lDOCI/lDOCI.github.io/docs/Модификации.md

> [← Оглавление](index.md)

# Модификации

Печатные и аппаратные доработки AD5M/5M Pro. Модификации для **AD5X** — на [отдельной странице](AD5X-Печатные-модификации.md).

## Зашивка корпуса (термокамера)

Зашивка снижает разницу температур → меньше коробления ABS/ASA/композитов и отрывов PETG.

- [Родная зашивка FlashForge](https://wiki.flashforge.com/en/knowledge_corner/printer-mod-and-diy) — официальные модели/инструкция.
- [Минималистичная зашивка (мало печати)](https://www.printables.com/model/1002724-flashforge-adventurer-5m-enclosure/files).
- [Версия под акриловые панели от оригинальной зашивки](https://www.printables.com/model/1063430-flashforge-ad5m-minimal-enclosure).
- [Superliminal enclosure — панели + металлические уголки/профили](https://www.printables.com/model/1054835-superliminal-enclosure-for-flashforge-adventurer-5).
- [ILYAS mod](https://t.me/ILYAS_mod_AD5m) — канал с набором доработок.

## Вентиляция и термокамера

- [Вентиляционный канал под вентилятор 5015](https://www.printables.com/model/910736-ventiliatsionnyi-kanal-dlia-adventurer-5m5m-pro).
- [Угольный фильтр 7530](https://www.printables.com/model/1221854-flashforge-ad5m-filtr-ugolnyi-7530) — для 5M/5M Pro. Для 5X: [контейнер угольного фильтра](https://www.printables.com/model/1499836-ad5x-active-carbon-filter-container).
- [Задняя крышка под вентилятор 120 мм](https://www.printables.com/model/838021-flashforge-adventurer-5m-ad5m-back-panel-w-120mm-4) — охлаждение моторного отсека (помогает против перегрева драйверов).
- [Колпак-кожух на весь принтер](https://www.printables.com/en/model/863467-3d-printer-sound-dampening-enclosure) — шумоизоляция.

## Хотенд

Главная боль стока — картриджный хотенд: сопло меняется только в сборе и дорого. Решают заменой хотенда на вариант со сменными соплами. **Это разные хотенды, а не один и тот же:**

- **Bambu-mod** — печатная голова под хотенд **Bambu Lab** (X1C/P1S): дешёвые сменные сопла, хороший радиатор (нет пробок), удобное обслуживание. Печатать из ABS/ASA/композита. [Напечатать/собрать самому](https://www.printables.com/model/818473-flashforge-adventurer-5m-peredelka-pechatnoi-golov) · [версия с внешним вентилятором хотенда](https://www.printables.com/model/1002162-flashforge-adventurer-5m-bambu-lab-x1-hotend-mod).
- **Соплямод (соплемод)** — «франкенштейн»: радиатор и крепление от стока, хотенд от Bambu. Ставится **в родную голову**, ничего печатать не обязательно — но он немного длиннее стока, поэтому желательно распечатать новую крышку вентилятора обдува модели. Готовые версии на AliExpress: [v1](https://aliexpress.ru/item/1005008556375579.html) · [v2](https://aliexpress.ru/item/1005009895034159.html).
- **Conch** — **отдельный** готовый хотенд, без печати деталей: [AliExpress](https://aliexpress.ru/item/1005009996006548.html).
- **K1-мод** — печатная голова под хотенд **Creality K1**: [модель](https://www.printables.com/model/957502-ff-ad5m-k1-hotend).

**Разблокировка 291 → 320 °C** — см. [Прошивка](Прошивка.md#разблокировка-температуры-хотенда-291--320-c).

**Установка термистора PT1000** (рекомендуется при переходе на Bambu-mod — дешевле и стабильнее). Плата поддерживает нативно, в `printer.cfg`:
```
[extruder]
sensor_type: PT1000
pullup_resistor: 4700
```

> **Внимание:**
> Детали головы **нельзя печатать из PETG** (близко к горячей зоне — поплывут). Только ABS/ASA или нейлон.

## Обдув модели

Штатный обдув средний; кастомные сопла обдува (в т.ч. боковой под вентилятор 12032) печатают лучше стокового. Боковой обдув ставят на двусторонний скотч с подгонкой по высоте; полезен держатель PTFE-трубки для ровного загиба.

## Подсветка

Лента **24 В** подключается в жёлтый разъём платы с подписью **LED** (полярность подписана), коннектор **2pin XH2.54**.

- [Под обычную ленту 10 мм](https://www.printables.com/model/786611-flashforge-adventurer-5m-led-bar-with-magnets).
- COB-лента: [v1](https://www.printables.com/model/821534-adventurer-5m-led-light-mounts) · [v2](https://www.printables.com/model/831737-flashforge-adventurer-5m-ad5m-led-mod).
- [Две ленты на одно крепление](https://www.printables.com/model/828632-flashforge-adventurer-5m-ad5m-led-light-bars-mod-a).
- [Крепление понижающего LM2596](https://www.printables.com/model/827706-flashforge-adventurer-5m-ad5m-led-mod-accessory-bu) — для 12 В ленты (есть и способ без понижайки).
- Подсветка на голову — отдельные модели.

**Регулировка яркости из G-code.** Штатно подсветка только включается и выключается. Скрипт сообщества добавляет произвольную яркость — в `printer.base.cfg`:

```
[gcode_macro M355]
gcode:
  {% set S = params.S|default(1.0)|float %}
  SET_LED LED=chamber_led WHITE={S}
```

В секцию `[led chamber_led]` можно дописать стартовую яркость:

```
initial_white: 0.05
```

Теперь в стартовом и завершающем G-code доступно: `M355 S1.0` — включить на 100 %, `M355 S0.05` — притушить до 5 %.

## Нагреватель камеры

Активная камера нужна для композитов и крупного ABS. Ключевое по безопасности:

> **Внимание:**
> Нагреватель на 200 Вт — это ~10 А плюс вентилятор. **Питать его от штатного блока питания нельзя** — очень вероятно, что БП не выдержит. Либо ставьте БП на 450–500 Вт, либо питайте от отдельного источника.
>
> Управляющие блоки китайских наборов идут с реле сомнительного качества. Под такую нагрузку ставьте внешнее реле — например, 24 В / 30 А.

## Камера

- [Оригинальная камера FF](https://aliexpress.ru/item/1005006448963071.html) — штатное крепление, проще всего.
- Любая USB-веб-камера — в USB-порт экрана или обжать в задний разъём (список рабочих — в [Прошивке](Прошивка.md#камеры-usb)).
- [Держатель OV9726](https://www.printables.com/model/1252969-ov9726-camera-holder-ad5m) · [крепление OV3660](https://www.printables.com/model/1385004-ov3660-camera-mount-to-flashforge-adventurer-5m-ad) · [Arducam](https://www.printables.com/model/810240-flashforge-adventurer-5m-arducam-camera-mount) · [держатель под Logitech C310](https://www.printables.com/model/894405-logitech-c-310-camera-holder-for-flashforge-advent).

## Плата и питание

- **Кнопка вкл/выкл как на Pro** — вынос питания на лицевую панель (соблюдая ПБ по 220 В и предохранитель).
- **Обновление 5M → Pro** — программно добавляет часть функций (кнопка подсветки на экране); см. [Общее](Общее.md).
- **Снижение шума вентилятора БП** — замена/доработка обдува (см. также [Электроника](Электроника.md)).

## Внешний хост

Самая радикальная доработка после [замены процессора](Электроника.md#расширение-озу-замена-процессора-t113-s3--t113-m4). Смысл: Klipper и Moonraker переезжают на отдельный одноплатник (или старый ПК/ноутбук), а родная плата остаётся исполнителем. Потолок в 128 МБ перестаёт мешать.

**Что это даёт:**

- Уходит [E0017](Исправление-ошибок.md#e0017--move-queue-overflow) — очередь движений считает нормальный компьютер.
- Полноценный Klipper без урезаний, любые плагины.
- Телеграм-бот, таймлапсы, нормальная камера — всё то, что на родном хосте не влезает по памяти. Бота и так рекомендуют запускать вне принтера.
- Камеру можно повесить на тот же хост (`ustreamer` отдаёт поток на `IP_хоста:8080`, дальше URL прописывается в веб-морду).

**Чем платите:**

- Коробка с одноплатником рядом с принтером и провода наружу. Многие делают под это отдельную плату-переходник, чтобы сзади не было «релейного шкафа».
- Связь по USB чувствительна к наводкам — возможны дисконнекты. Ставьте нормальный экранированный кабель, не тяните длинный.
- Нужно корректно отключить родной Klipper, иначе два хоста дерутся за плату.
- Обслуживать теперь надо две системы.

**Инструкция:** [VoronKor / flashforge-adventurer-5m-connecting-an-external-host](https://github.com/VoronKor/flashforge-adventurer-5m-connecting-an-external-host-) — схема подключения и порядок настройки.

> **Совет:**
> Если цель — только убрать E0017 и получить веб-морду, начните с [мода на прошивку](Прошивка.md): это решается без паяльника. Внешний хост берут, когда упёрлись в память всерьёз — плагины, бот, вторая камера.

## Механика и ремни

Натяжители ремней, проставки против люфта, перепечатка креплений моторов, апгрейд на широкие ремни (Powge × D3vil K1) — в [Обслуживании](Обслуживание.md).
