lDOCI/lDOCI.github.io/docs/index.md

# База знаний — FlashForge Adventurer 5M / 5M Pro / 5X

Практическая вики по принтерам FlashForge Adventurer 5M / 5M Pro / 5X. Материал собран и обобщён из обсуждений сообщества в виде статей «как сделать / симптом → причина → решение».

## Разделы

| Страница | О чём |
|---|---|
| [Термины и сокращения](Термины.md) | Глоссарий: Klipper, root/SSH, карта стола, шейперы, PA, ретракт, IFS и т.д. — для новичков |
| [Частые проблемы (FAQ)](Решение-проблем.md) | Симптом → решение → ссылка: пробки, адгезия, поддержки, смещение слоёв, кирпич, ошибки |
| [Общее](Общее.md) | Недостатки AD5M и их устранение, отличия 5M / 5M Pro |
| [Прошивка](Прошивка.md) | Сток и моды, root/SSH, 291→320 °C, конфиги, датчики |
| [Калибровка](Калибровка.md) | Стол, тензодатчики, Z-offset, точность, натяжение ремней, шейперы, утилиты калибровки |
| [Обслуживание](Обслуживание.md) | Направляющие/смазка (Циатим-221F), ремни, шлейфы, хотенд, шестерни фидера |
| [Печать](Печать.md) | Засор/колдпул, первый слой, адгезия, поддержки, ретракты, дефекты |
| [Материалы](Материалы.md) | PLA/PETG/ABS/ASA/TPU/PA/PC, сушка, температуры |
| [Слайсер и профили](Слайсер-и-профили.md) | Orca-FF / OrcaSlicer, профили, стартовый/завершающий G-code, макросы |
| [Электроника и железо](Электроника.md) | Плата, моторы, драйверы, термисторы/PT1000, БП, датчики, восстановление |
| [Сеть и удалёнка](Сеть-и-удалёнка.md) | Wi-Fi, удалёнка, Home Assistant, боты, обновления/облака |
| [Модификации](Модификации.md) | Зашивки, обдув, термокамера, хотенд-моды, подсветка, камеры, плата |
| [Дефекты печати](Дефекты-печати.md) | 16 типовых дефектов (недоэкструзия, гостинг, паутина, варпинг…) — причины и решения с фото |
| [Филаменты (онлайн-таблица)](https://ldoci.github.io/filaments/) | Каталог катушек: тип, вес, размеры, ссылки на покупку — с фильтром и поиском |
| [Исправление ошибок](Исправление-ошибок.md) | Коды ошибок, E0017, E0011, восстановление серийника |

## AD5X

Отдельная линейка — Adventurer 5X с IFS, 220В-столом, 512 МБ ОЗУ и ножом обрезки филамента.

| Страница | О чём |
|---|---|
| [AD5X: Старт и различия](AD5X-Старт-и-различия.md) | Отличия от 5M, root/SSH, factory-прошивка, возврат на сток |
| [AD5X: Прошивка](AD5X-Прошивка.md) | Home offset, настройка ножа, регулировка корзины IFS |
| [AD5X: Реверс](AD5X-Реверс.md) | Система IFS (схемы, бэкап), размеры хотендов, сопла |
| [AD5X: Печатные модификации](AD5X-Печатные-модификации.md) | Bambu-каретка, кнопка питания, обдув, филамент-хаб |
| [AD5X: Корпус](AD5X-Корпус.md) | Зашивка, боковые панели, надстройки |

## Прошивки — актуальные версии

| Прошивка | Версия | Дата | Примечание |
|---|---|---|---|
| [ZMod](https://github.com/ghzserg/zmod) | 1.7.1 | 2026-05-14 | поверх стока, Fluidd, +AD5X |
| [Forge-X](https://github.com/DrA1ex/ff5m) | 1.4.1 | 2026-02-18 | развитие ZMod, максимум функций |
| [KlipperMod](https://github.com/xblax/flashforge_ad5m_klipper_mod) | v00.06-beta | 2025-09-08 | полная замена прошивки |
