lDOCI/lDOCI.github.io/docs/AD5X-Старт-и-различия.md

> [← Оглавление](index.md)

# AD5X: Основное

## Оглавление
1. [Отличия 5X от 5M](#отличия-ad5x-от-ad5m)
2. [Получение Root (SSH)](#1-получение-root-доступ-к-ssh)
3. [Видео по сборке/разборке](#2-официальные-видео-инструкции)
4. [Factory прошивка](#3-factory-прошивка-и-калибровка)
5. [Держатель катушки](#4-держатель-под-широкие-катушки)
6. [Возврат на сток](#5-установка-оригинальной-прошивки)
7. [Прижим ножа (Bambu Mod)](#6-прижимнаправляющая-ножа)

---

## Отличия AD5X от AD5M
Список технических изменений:

1. **Нагревательный стол:** 220В (вместо 24В).
2. **ОЗУ:** 512 Мб (вместо 128 Мб).
3. **IFS:** Система смены филамента установлена с завода.
4. **Плата головы:** Новая ревизия уменьшенного размера.
5. **Хотенд:** Изменена конструкция, установлен клон Bambu Lab (более доступные сопла).
6. **Кинематика:** Валы по оси X увеличены до 10 мм (ранее 8 мм).
7. **Питание:** Установлен новый блок питания.
8. **Тензодатчики:** Обновлена прошивка тензомодуля.
9. **Механика:** В голову добавлен нож для обрезки филамента.
10. **Датчики:** Установлен датчик застревания филамента.

---

## Объективные минусы AD5X и их решения

**Железо:**
- **Слабое сопло** → замена на сопло/хотенд Bambu Lab (A1 / A1 mini) или Triangle (размеры и ссылки — в [Реверс → сопла](AD5X-Реверс.md)).
- **Грелка хотенда часто горит** → замена головы на Bambu-mod либо отдельного нагревателя Bambu.
- **Щёлкают крепления катушки IFS** → меняют по гарантии.
- **Неудачный модуль 4-в-1 (IFS)** → замена по гарантии или печать своего.
- **Слетает прошивка модуля IFS** → высылают новый по гарантии, старый можно перешить.
- **Периодически теряется Z-offset** → снимать карту стола перед печатью; на ZMod — автоподбор Z-offset / плагин `g28_tenz`. На прошивке 1.1.9 есть попытка штатного решения, но она спорная — см. ниже.

**Софт:**
- **Закрытая прошивка** — работа только через родные Orca-FF / FlashPrint, китайские серверы периодически лежат.
- **Бьются файлы** при передаче — включить контроль MD5, см. [Исправление ошибок](Исправление-ошибок.md#битые-файлы-печати--проверка-md5).
- **Много отходов при смене цвета** — настраивается, см. ниже про IFS.
- **Нет веб-интерфейса, пережатая картинка камеры, нет поддержки сторонних камер.**
- **Кривой Z-offset на прошивке 1.1.9+** — у большинства становится хуже; решение — откат на 1.1.7.
- **Klipper вылетает при больших исключениях объектов** — отключить Exclude Objects в Orca.

> **Про софтовые пункты:**
> Почти все они закрываются установкой мода на прошивку — он даёт веб-интерфейс, доступ к конфигу, нормальную камеру и плагины. Что выбрать и как ставить — в статье [Прошивка](Прошивка.md).

---

## 1. Получение Root (Доступ к SSH)
SSH-сервис активен на принтере по умолчанию. Данный патч выполняет сброс пароля суперпользователя.

* **Скачать патч:** [Загрузить ZIP](https://github.com/lDOCI/Flashforge/releases/download/Adventurer/AD5X-root.tgz)

**Инструкция:**
1. Распаковать архив в корень USB-флешки.
2. Вставить флешку в выключенный принтер.
3. Включить принтер.
4. Дождаться полной загрузки и перезагрузить устройство.
5. **Логин:** `root`
6. **Пароль:** `root`

> Альтернативный способ: получение прав через [ZMOD](https://ghzserg.github.io/).

[Наверх](#оглавление)

---

## 2. Официальные видео-инструкции
Плейлист с процессом сборки и обслуживания узлов.

[Смотреть на YouTube](https://www.youtube.com/watch?v=sCWYyMsJgKA&list=PLJPwfr1YNWWlQWguuuYyE0y62yOKJvNY-)

---

## 3. Factory прошивка и калибровка
Сервисное ПО и программа для калибровки офсетов головы.

* **Скачать Factory Firmware:** [Ссылка на файл](https://github.com/lDOCI/Flashforge/releases/download/Adventurer/AD5X-factory-1.0.9.tgz)
* **Скачать Calibration Tool:** [Ссылка на файл](https://github.com/lDOCI/Flashforge/releases/download/Adventurer/xy.zip)

[Наверх](#оглавление)

---

## 4. Держатель под широкие катушки
Модифицированная модель держателя.

* **Скачать STL:** [Printables](https://www.printables.com/model/1219490-ad5x-spool-holder-remixed)

---

## 5. Установка оригинальной прошивки
Полная стоковая прошивка версии 1.0.9 (без ZMOD).

**Порядок действий:**
1. Загрузите следующие файлы в корень флешки:
 * `AD5X-factory-1.0.9.tgz`
 * `AD5X-factory.tar.xz`
 * `config.tar` (восстанавливать только при наличии ранее сделанного бекапа)
2. Вставьте флешку в принтер.
3. Перезагрузите устройство.

* **Источник файлов:** [GitHub ZMOD Releases](https://github.com/ghzserg/zmod/releases/tag/R)

[Наверх](#оглавление)

---

## 6. Прижим/направляющая ножа
Модификация для голов с установленным хотендом от Bambu Lab. Устраняет зажевывание пластика при печати TPU.

* **Скачать STP:** [Ссылка на файл](https://github.com/lDOCI/Flashforge/releases/download/Adventurer/ad5x_.stp)

**Требования к установке:**
1. Перед монтажом сдвинуть хотенд максимально низко.
2. После установки **обязательно** выполнить перекалибровку стола.

[Наверх](#оглавление)
