lDOCI/lDOCI.github.io/docs/Дефекты-печати.md

> [← Оглавление](index.md)

# Дефекты печати — причины и решения

Справочник по типовым дефектам качества печати (на основе официальной методички FlashForge и опыта сообщества). У каждого дефекта — фото проблемы, причина и решение; скриншоты настроек убраны в сворачиваемые блоки, чтобы не мешали читать.

Связанные статьи: [Печать](Печать.md) · [Калибровка](Калибровка.md) · [Материалы](Материалы.md).

---

## 1. Недоэкструзия (пластика выдавливается мало)
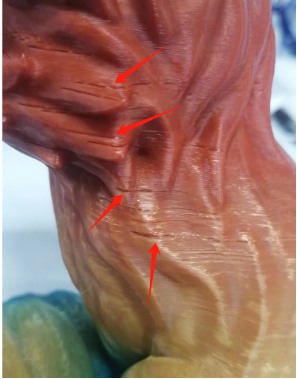
[picture p9: docs/assets/problems/1.under_extrusion_during_printing.png]


**Причина 1 — плохой/неподходящий филамент или низкая температура.**
- Замените филамент; выставьте температуру по рекомендации с катушки (+~15 °C из-за нержавеющего сопла, см. [Печать](Печать.md)).

**Причина 2 — нагар/закоксовка в сопле.** Признак: при ручной подаче нить тоньше 0.45 мм (норма 0.5 ± 0.03 мм).
- Замените сопло или сделайте cold pull ([Печать](Печать.md)).

## 2. Линии слоёв (видны полосы по высоте)
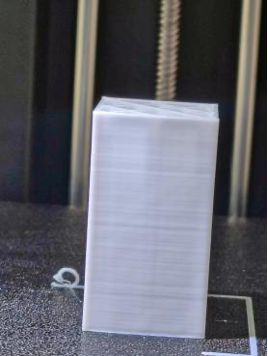
[picture p10: docs/assets/problems/2-1.layer_lines_on_3d_prints.png]


**Причина — неплавное движение по оси Z** (шум/подклинивание).
- Смажьте ходовой винт Z (подробно — в [Обслуживании](Обслуживание.md)).
- Если смазка не помогла, причина глубже: биение ходового винта, люфт антивоблинговых гаек, неравномерный ход трёх кареток Z. Подробный разбор с замерами — [PDF «Полосы по оси Z»](assets/pdf/Полосы-по-оси-Z-разбор.pdf).

<details markdown="1"><summary>Шаги смазки винта Z (скриншоты)</summary>

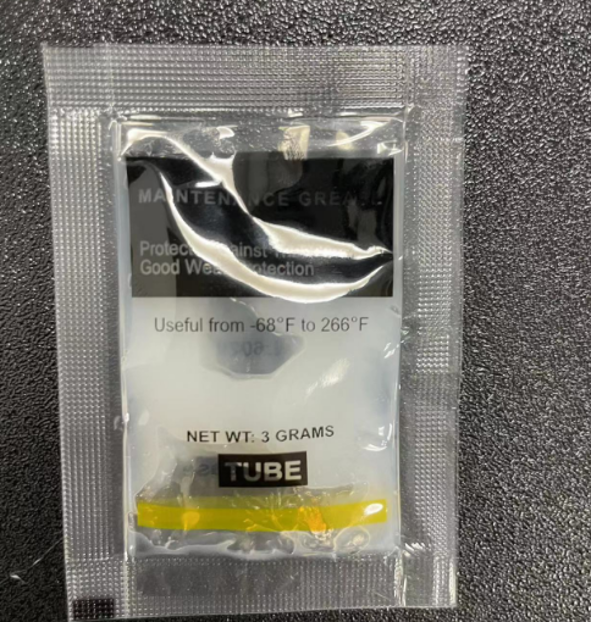
[picture p11: docs/assets/problems/2-2.layer_lines_on_3d_prints.png]

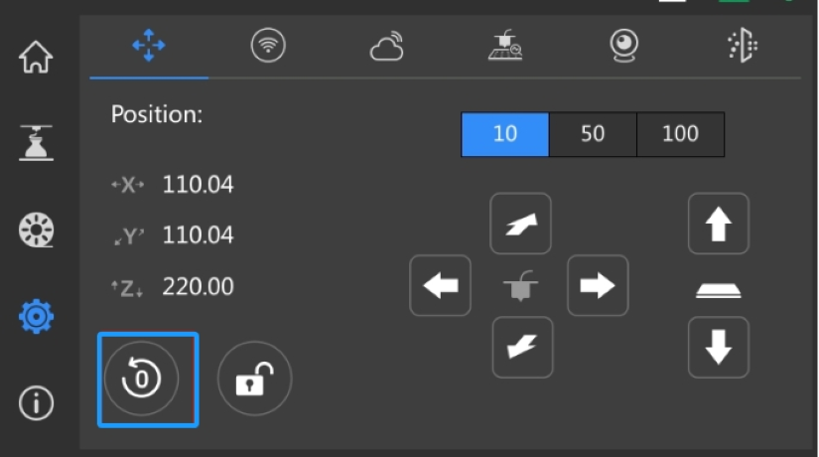
[picture p12: docs/assets/problems/回零.png]


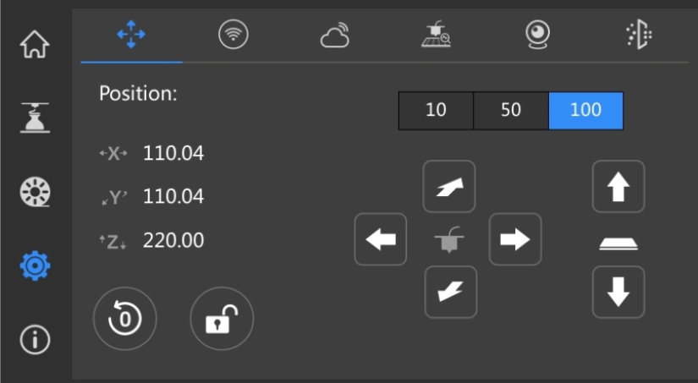
[picture p13: docs/assets/problems/100site2.png]


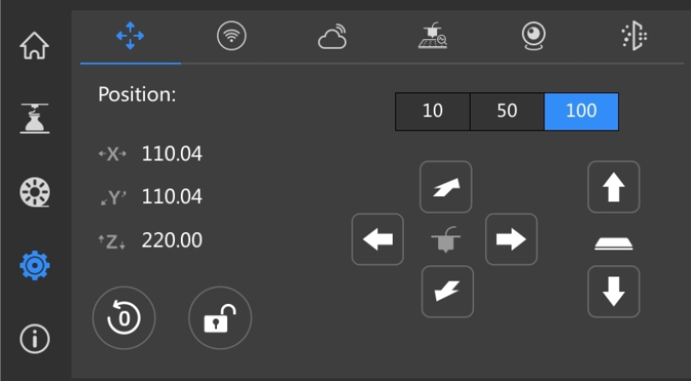
[picture p14: docs/assets/problems/100site.png]


</details>

## 3. Гостинг (эхо) и звон (ringing)
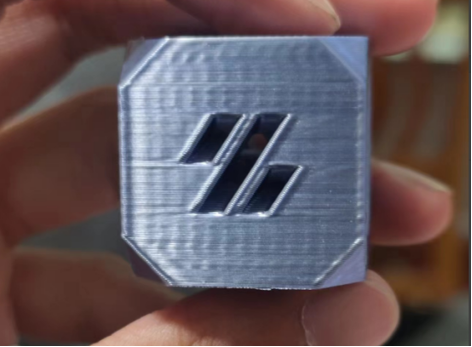
[picture p15: docs/assets/problems/3-1.ghosting&ringing.png]


**Причина — слабое натяжение ремней / высокое ускорение.**
- Подтяните ремни и пересоберите Input Shaper ([Калибровка](Калибровка.md)).
- Снизьте ускорение в Orca: *Speed → Acceleration → Normal printing*.

<details markdown="1"><summary>Настройка ускорения</summary>

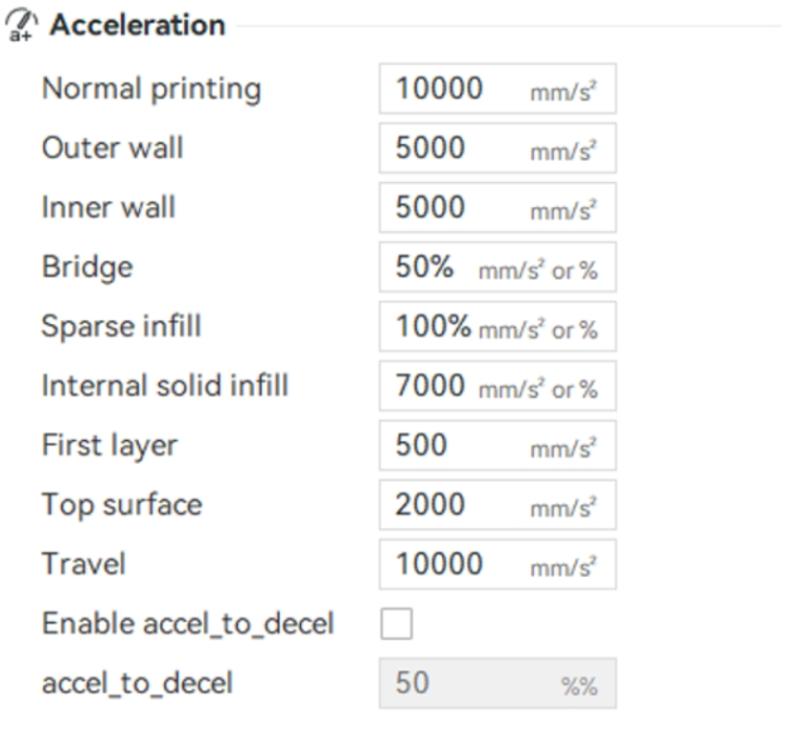
[picture p16: docs/assets/problems/加速度.png]

</details>

## 4. Провисание нависаний (droopy overhangs)
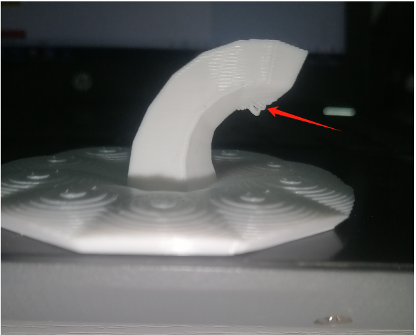
[picture p17: docs/assets/problems/4-1.droopy_overhangs.png]


- Включите *Slow down for overhangs* в Orca.
- Добавьте поддержки для нависаний круче 30°.
- Усильте обдув / увеличьте время остывания слоя.
- Проверьте вентилятор обдува детали (мог выйти из строя).

<details markdown="1"><summary>Настройки (нависания, охлаждение)</summary>

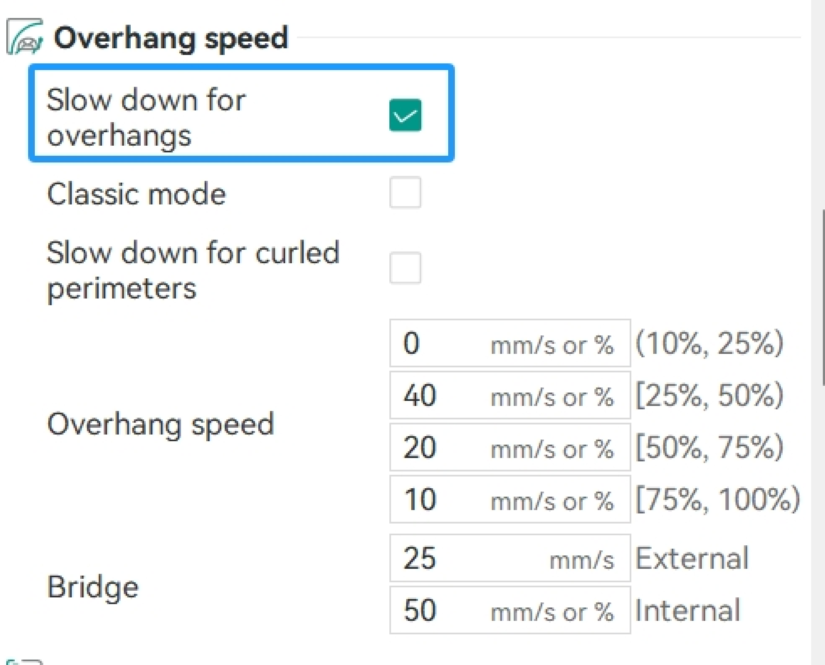
[picture p18: docs/assets/problems/悬垂降速.png]

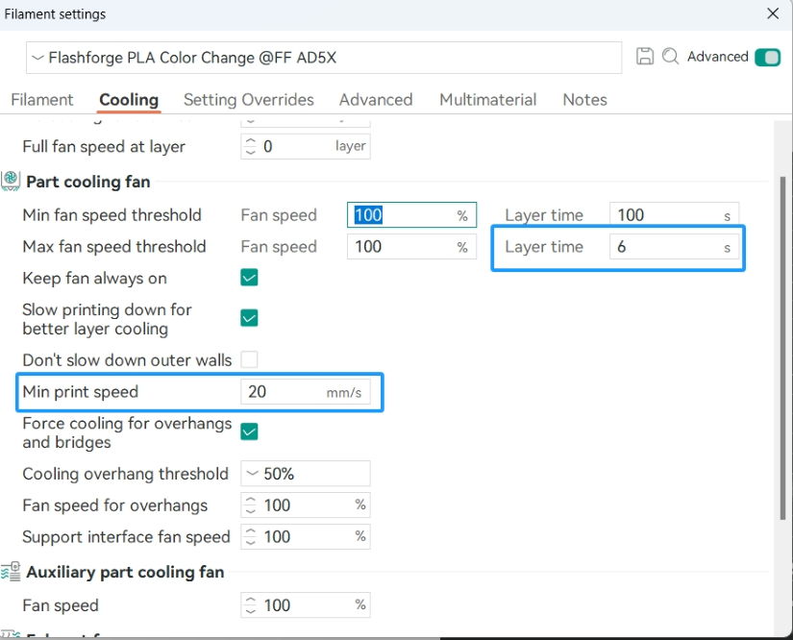
[picture p19: docs/assets/problems/冷却.png]

</details>

## 5. Паутина / стрингинг (тонкие нити между деталями)
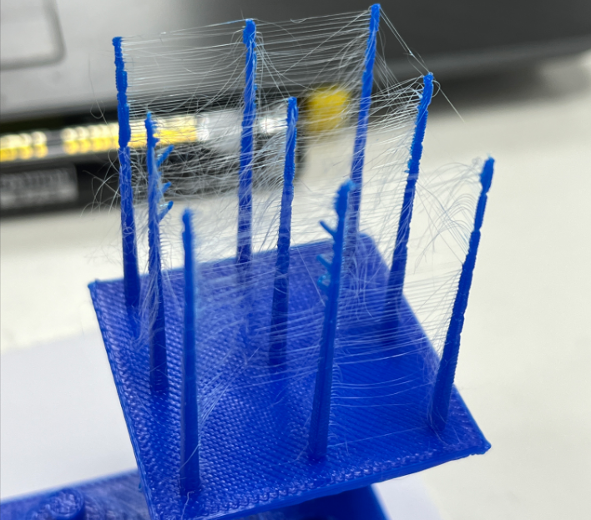
[picture p20: docs/assets/problems/5-1.stringing.png]


- **Просушите филамент** (PLA, PETG, PLA-CF особенно гигроскопичны) — см. [Материалы](Материалы.md).
- Увеличьте дистанцию и скорость отката (retraction) в Orca.

<details markdown="1"><summary>Настройки отката</summary>

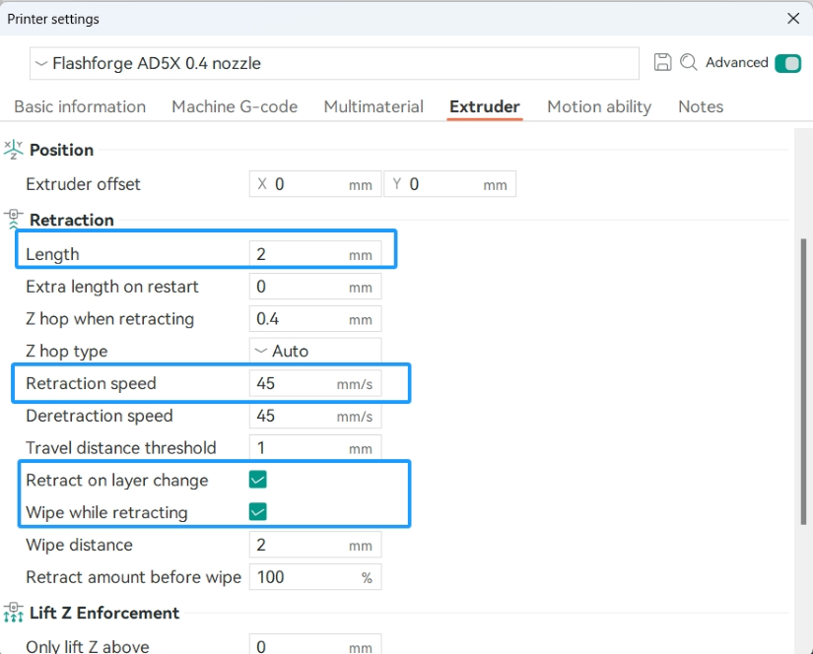
[picture p21: docs/assets/problems/回抽设置.png]

</details>

## 6. Шероховатость на мелких зонах (FlashPrint 5)
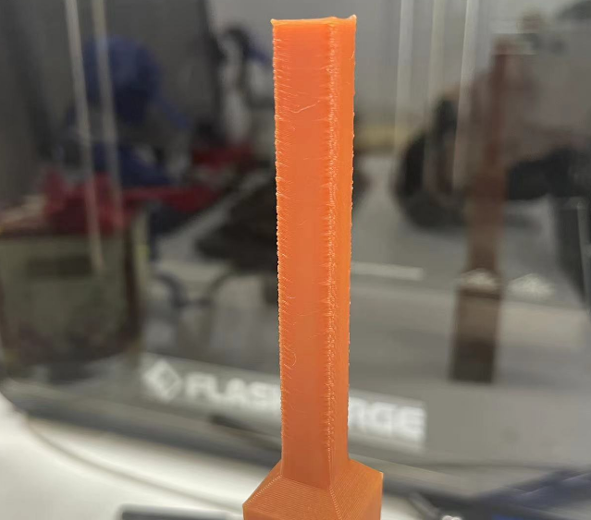
[picture p22: docs/assets/problems/6-1._for_models_sliced_by_flashprint_5.png]


- Настройте порог *Max fan speed threshold*, чтобы принтер замедлялся на коротких слоях.

<details markdown="1"><summary>Настройка</summary>

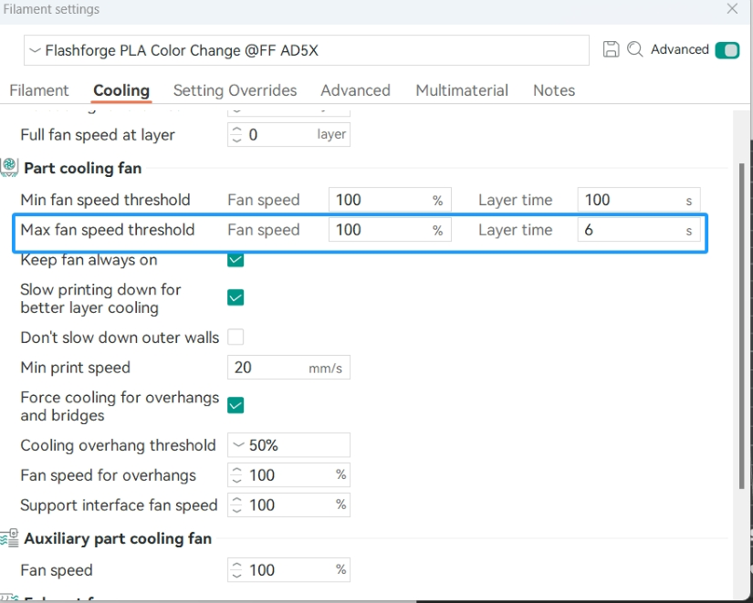
[picture p23: docs/assets/problems/冷却降速.png]

</details>

## 7. Зазоры между заполнением и контуром
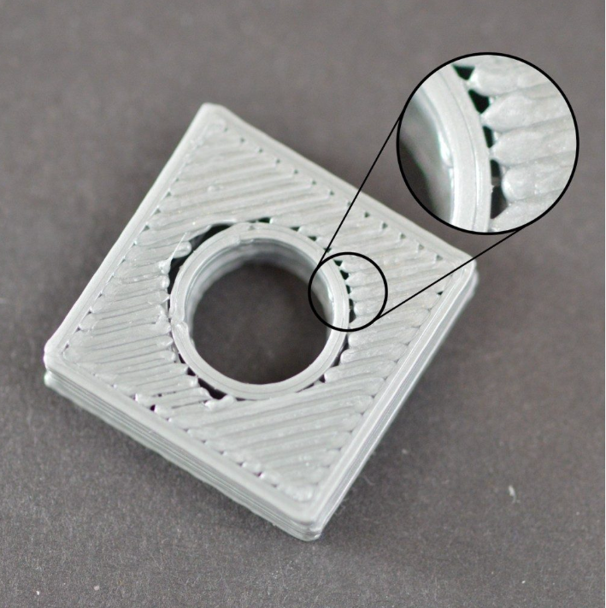
[picture p24: docs/assets/problems/ty1.png]


- Включите нахлёст заполнения на стенки: *Process → Strength → Top/Bottom solid infill/wall overlap* ≈ 25 %.
- Снизьте скорость для *Top surface*.

<details markdown="1"><summary>Настройки</summary>

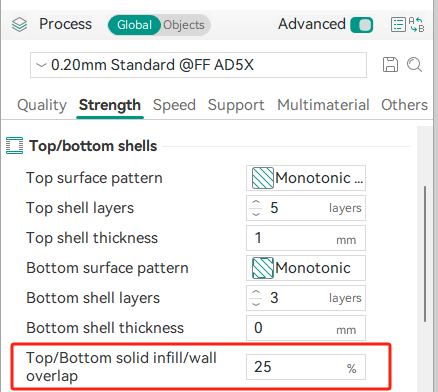
[picture p25: docs/assets/problems/t2.png]

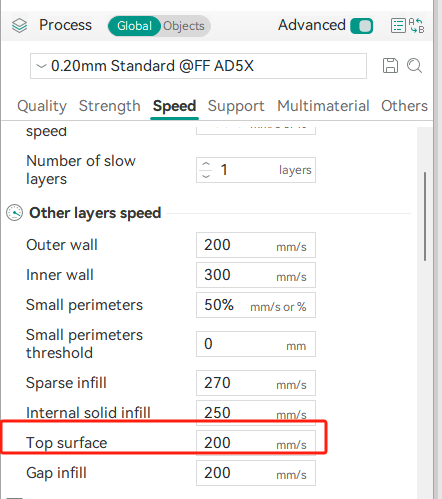
[picture p26: docs/assets/problems/t3.png]

</details>

## 8. Перегрев (оплывание мелких деталей)
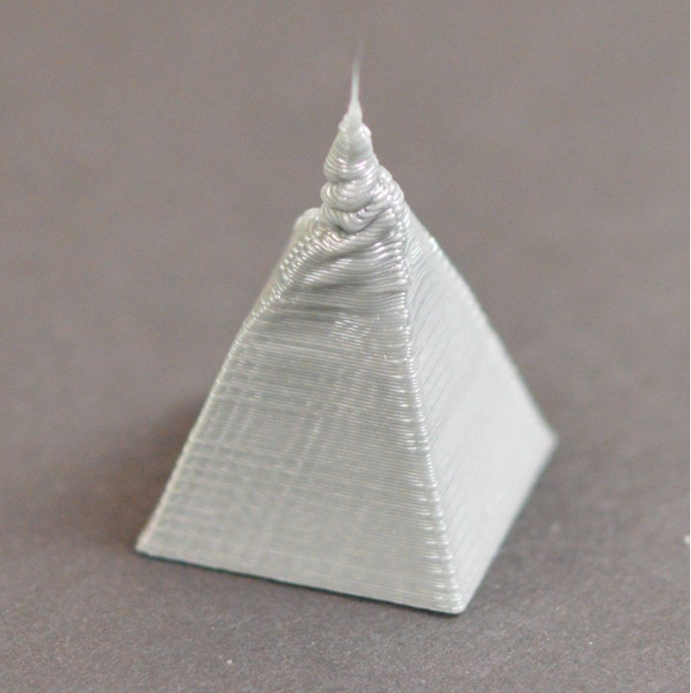
[picture p27: docs/assets/problems/t4.png]


- Увеличьте *Layer cooling time* в настройках материала.
- Снизьте температуру на 5–10 °C или уменьшите *Max volumetric speed*.

<details markdown="1"><summary>Настройки</summary>

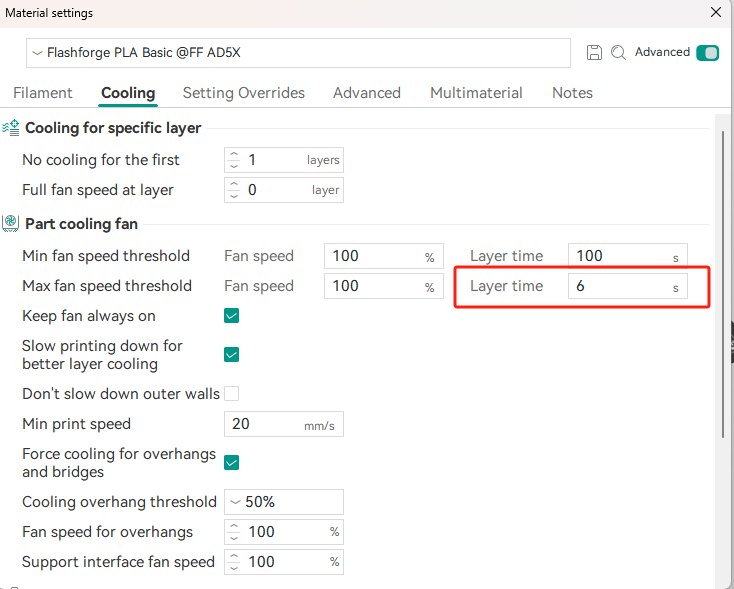
[picture p28: docs/assets/problems/t5.png]

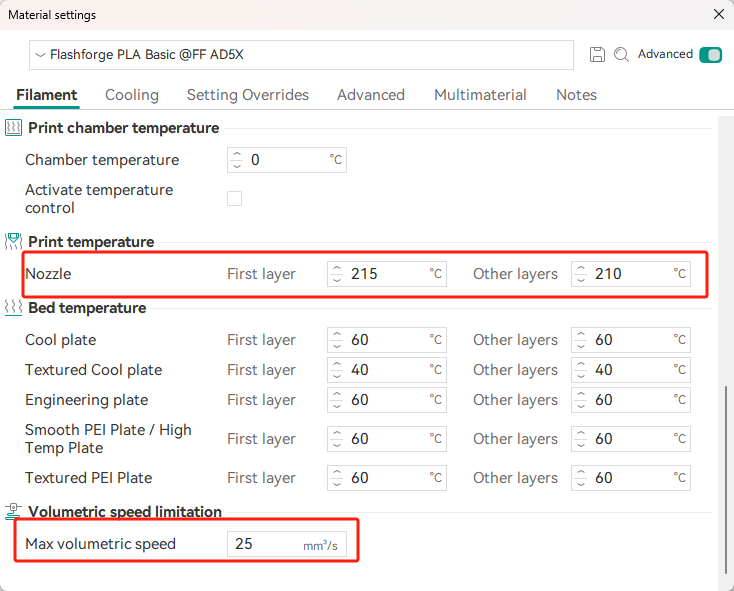
[picture p29: docs/assets/problems/t6.png]

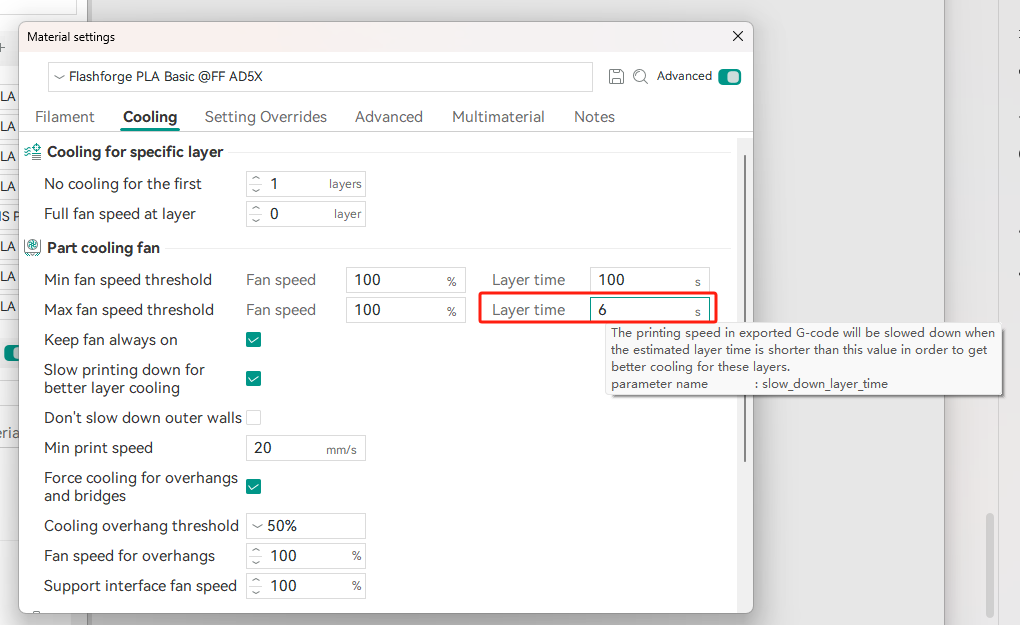
[picture p30: docs/assets/problems/t7.png]

</details>

## 9. Слабое заполнение / недоэкструзия
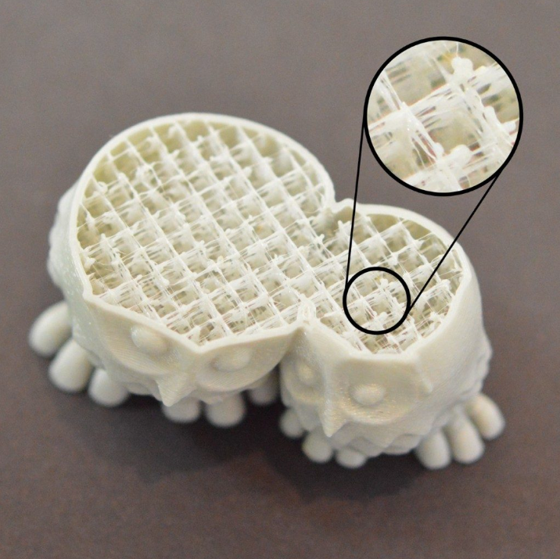
[picture p31: docs/assets/problems/t8.png]


- Проверьте износ сопла; повысьте температуру или снизьте скорость.

<details markdown="1"><summary>Настройки</summary>

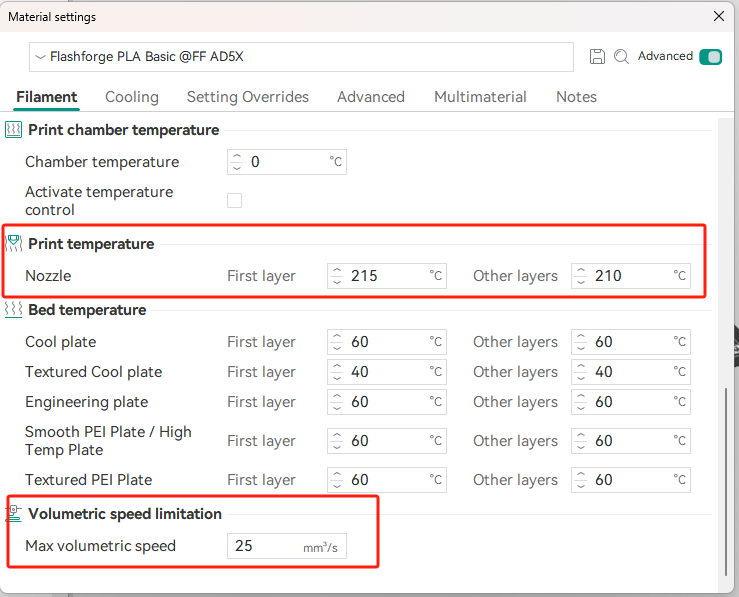
[picture p32: docs/assets/problems/t9.png]

</details>

## 10. Волосение (stringing)
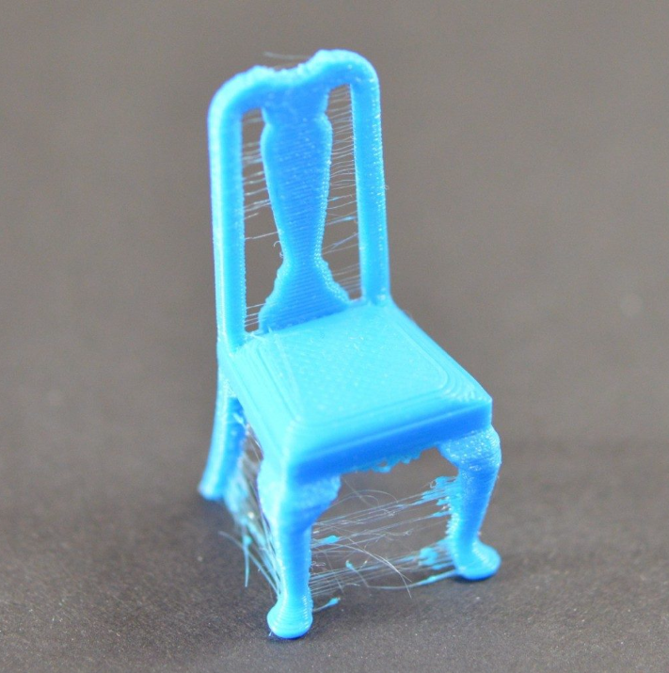
[picture p33: docs/assets/problems/t10.png]


- Просушите нить, снизьте скорость печати и температуру сопла.

<details markdown="1"><summary>Скриншоты</summary>


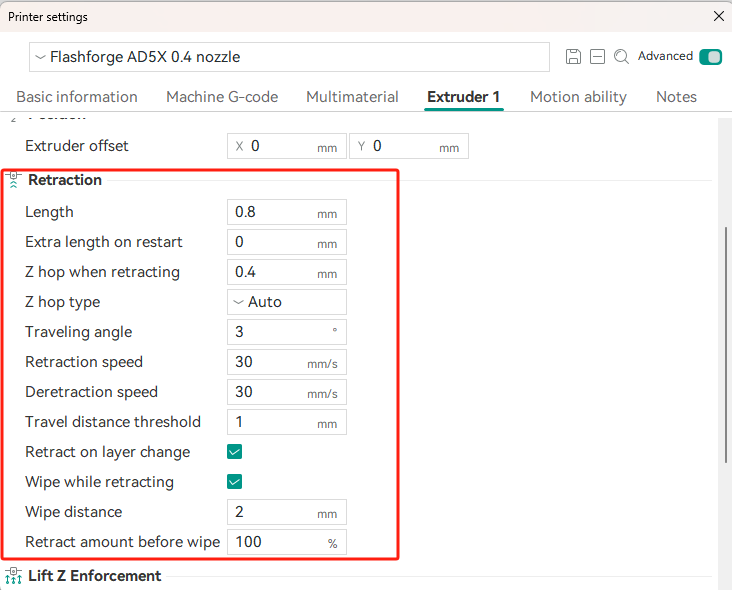
[picture p34: docs/assets/problems/t12.png]

</details>

## 11. Расслоение и трещины слоёв
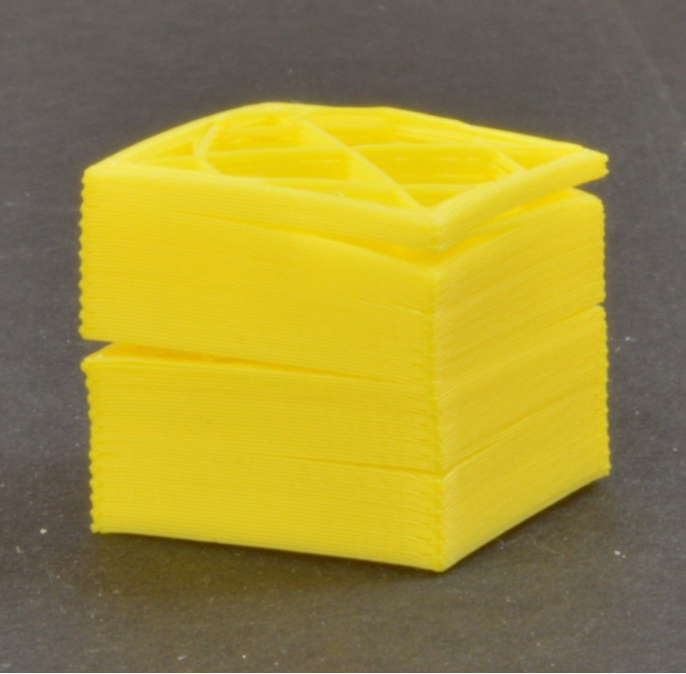
[picture p35: docs/assets/problems/t13.png]


- Снизьте обдув, повысьте температуру, уменьшите *Max volumetric speed*.

<details markdown="1"><summary>Скриншоты</summary>

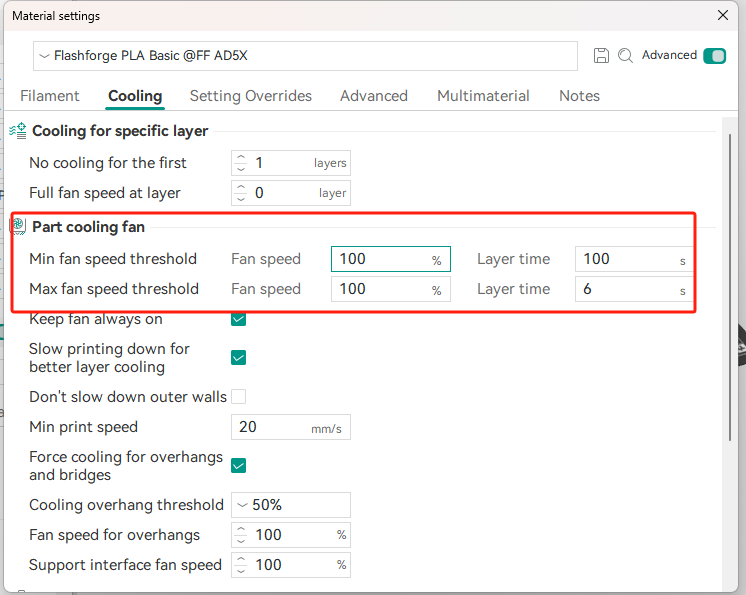
[picture p36: docs/assets/problems/t14.png]

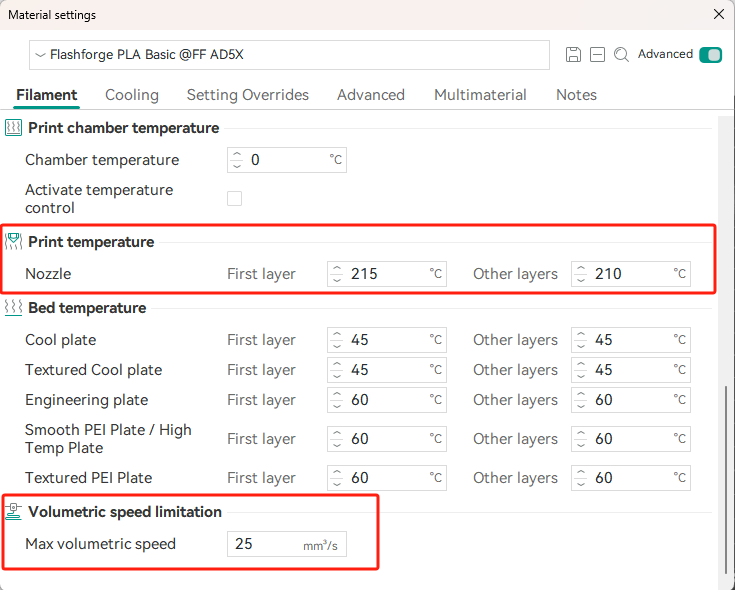
[picture p37: docs/assets/problems/t15.png]

</details>

## 12. Смещение слоёв (layer shifting)
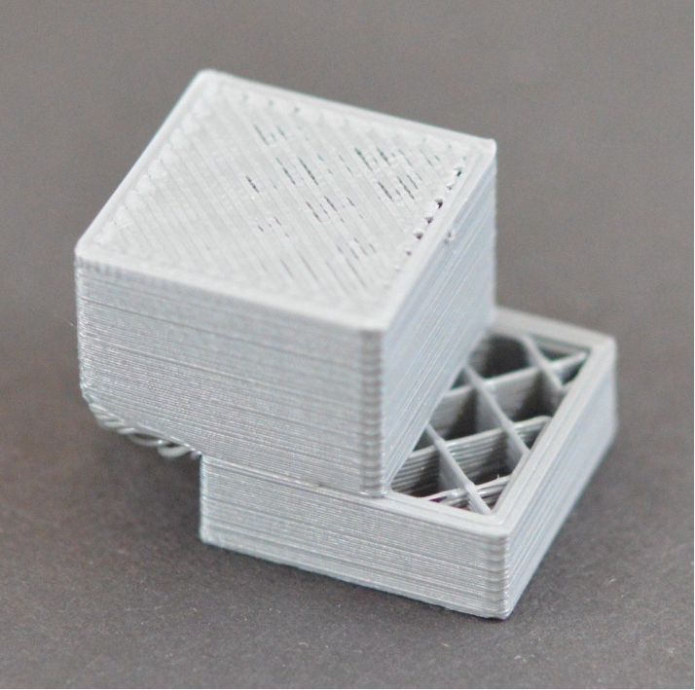
[picture p38: docs/assets/problems/t16.png]


- Устраните столкновение сопла с моделью; снизьте скорость/ускорение.

<details markdown="1"><summary>Скриншоты</summary>

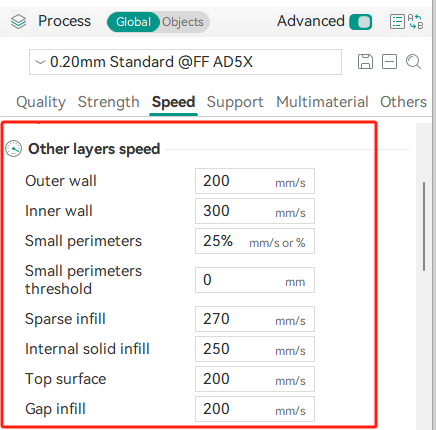
[picture p39: docs/assets/problems/t17.png]

</details>

## 13. Деформация / коробление (warping)
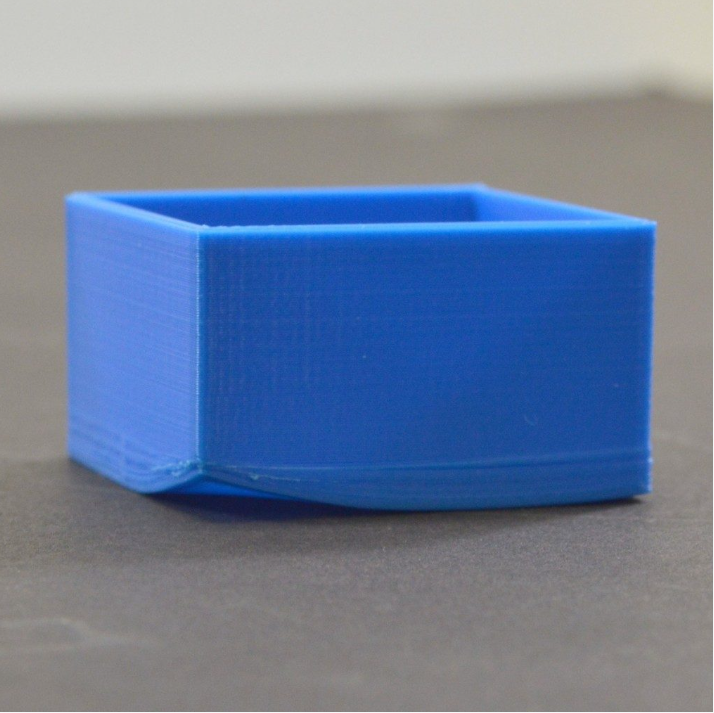
[picture p40: docs/assets/problems/t18.png]


- Очистите стол, поднимите температуру стола, снизьте скорость первого слоя. Подробнее про адгезию — [Печать](Печать.md).

<details markdown="1"><summary>Скриншоты</summary>

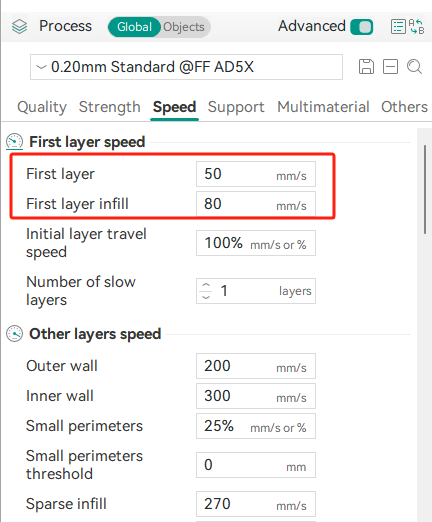
[picture p41: docs/assets/problems/t19.png]

</details>

## 14. Мелкие детали (плохо прорабатываются)
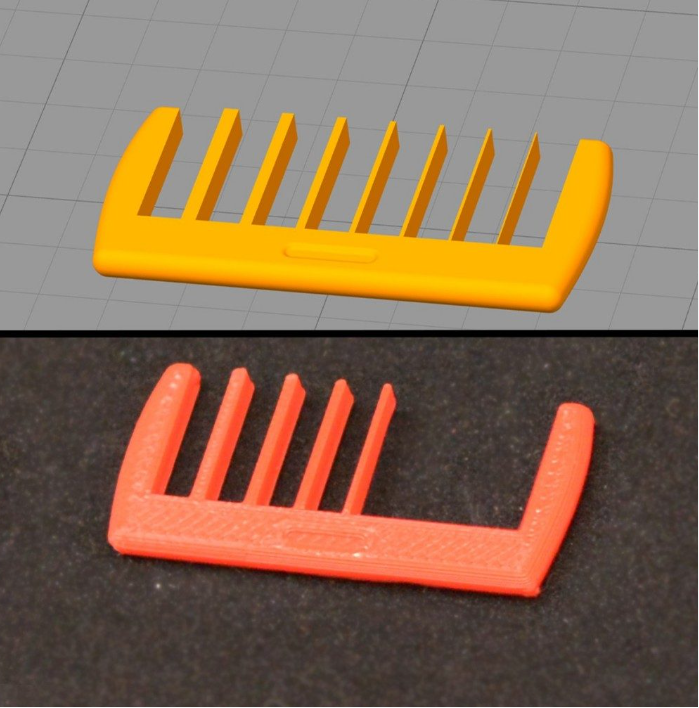
[picture p42: docs/assets/problems/t20.png]


- Уменьшите *Extrusion Width*, включите *Arachne* в генераторе стенок.

<details markdown="1"><summary>Скриншоты</summary>

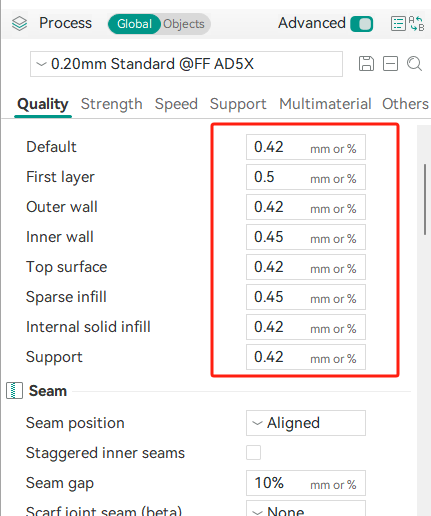
[picture p43: docs/assets/problems/t21.png]

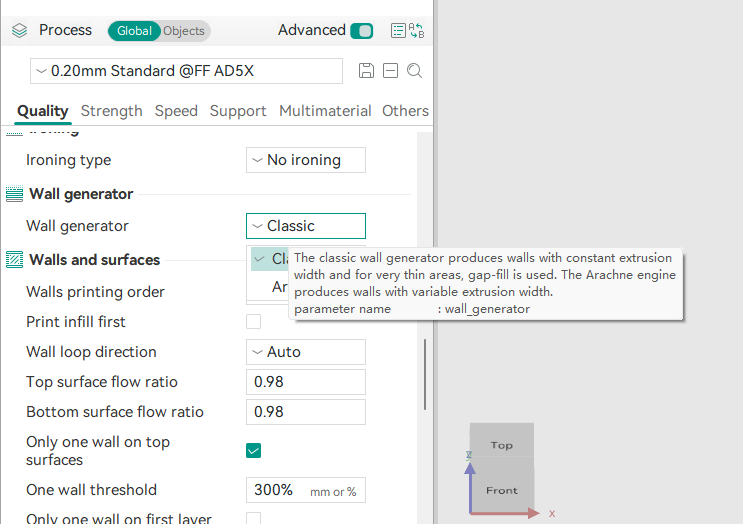
[picture p44: docs/assets/problems/t22.png]

</details>

## Вертикальная рябь и воблинг — сводный список причин

Если на стенках видна регулярная вертикальная рябь или «волна», причина почти всегда механическая. Проверять по списку:

**Ось Z**
1. Воблинг по Z из-за кривых ходовых винтов, с которым не справляется антивоблинг-механизм.
2. Заглушки/проставки, поставленные на каретки Z ради тишины — частый источник.
3. Винты Z не смазаны.
4. Винты Z смазаны слишком обильно — смазка забилась в гайку, антивоблинг застопорился и не работает.

**Экструзия**
5. Неверное разрешение экструдера (см. [Точность осей](Калибровка.md#точность-осей-разрешение)).
6. Слишком большой откат.
7. Плохо настроенный pressure advance.
8. Биение экструдера: не смазана ось прижимной лапки — выбить и смазать.
9. Биение экструдера: ось уже сточилась — менять, пока целы шестерни.

**Механика и режимы**
10. Болтающееся сопло.
11. Плохо натянутые или растянутые ремни.
12. Завышенные ускорения.

## 15. Гостинг / звон (вариант 2)
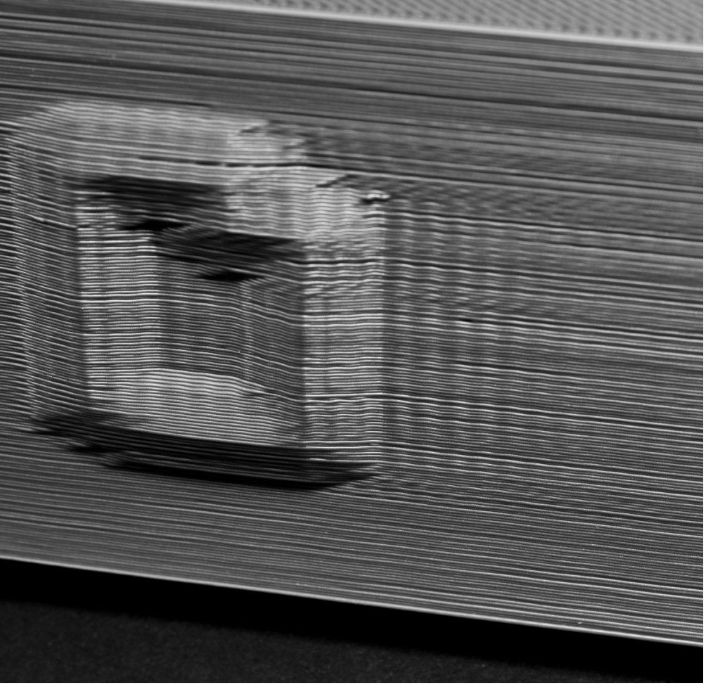
[picture p45: docs/assets/problems/t23.png]


- Отрегулируйте натяжение ремней, снизьте ускорения, выполните калибровку Input Shaper ([Калибровка](Калибровка.md)).

<details markdown="1"><summary>Скриншоты</summary>

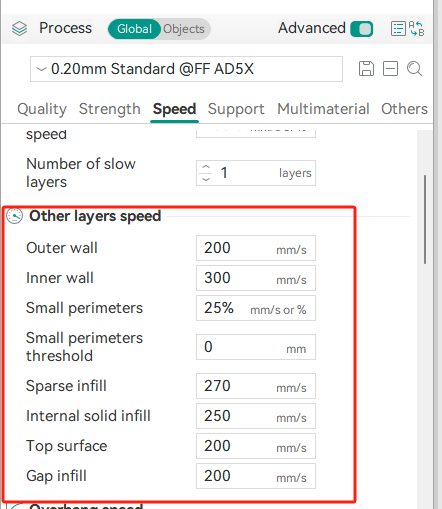
[picture p46: docs/assets/problems/t24.png]

</details>

## 16. Плохая поверхность над поддержками
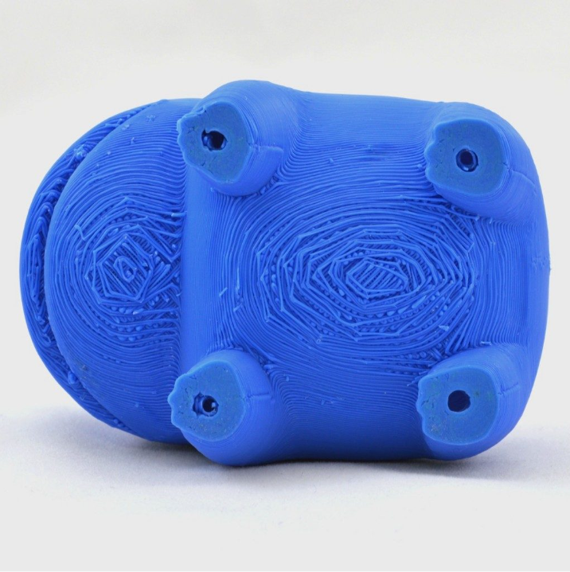
[picture p47: docs/assets/problems/t25.png]


- **Слишком большой зазор поддержек** — уменьшите *Support Spacing* (но не в ноль, иначе тяжело отрывать).
- **Слишком быстрая печать** — снизьте скорость для нависающих элементов.

<details markdown="1"><summary>Скриншоты</summary>

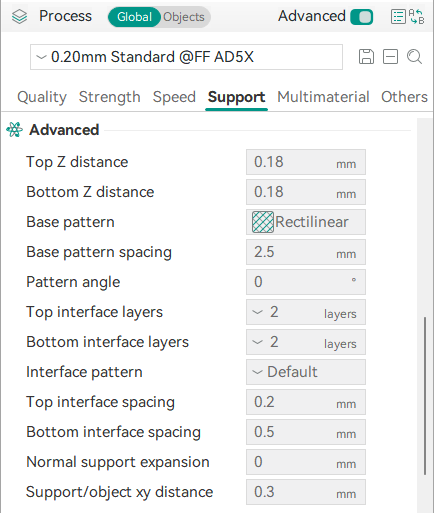
[picture p48: docs/assets/problems/t26.png]

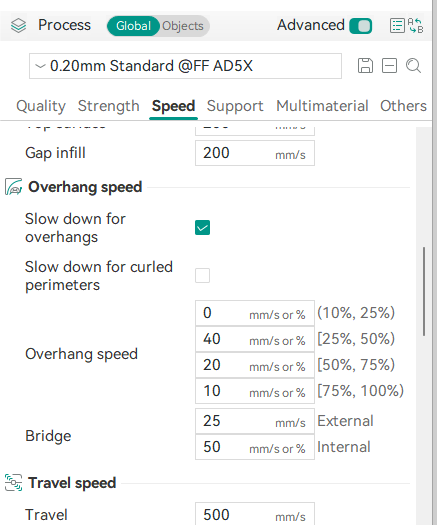
[picture p49: docs/assets/problems/t27.png]

</details>

---

Источник: справочные материалы wiki.flashforge.com, перевод и адаптация сообщества.

Дополнительно — сводный справочник сообщества: [Проблемы и дефекты 3D-печати, методы устранения (PDF)](assets/pdf/Проблемы-и-дефекты-3D-печати.pdf).
