lDOCI/lDOCI.github.io/docs/Решение-проблем.md

> [← Оглавление](index.md)

# Частые проблемы (FAQ)

Быстрые ответы на типовые вопросы новичков: симптом → что делать → где почитать подробно. Собрано из обсуждений по принципу «что реально помогает большинству».

## Печать срывается: пробки, щелчки экструдера, недоэкструзия
Стоковый картриджный хотенд склонен к пробкам (радиатор на магнитах плохо отводит тепло от горла), особенно при смене цвета и на разных пластиках.
- Быстро: **cold pull** + чистка сопла; иногда нужно разобрать картридж (на горячую), убрать старую «термопасту»/герметик с резьбы, собрать на нормальной термопасте, прогреть и заново сделать PID. См. [Печать → засор и cold pull](Печать.md#засор-сопла-и-cold-pull).
- Радикально: замена хотенда на вариант со сменными соплами — **Bambu-mod** (под хотенд Bambu Lab), **Соплямод** или **Conch** (отдельные хотенды) — у большинства пробки пропадают полностью. См. [Модификации → Хотенд](Модификации.md#хотенд).

## Первый слой не прилипает (особенно PETG)
- Снизьте **скорость первого слоя** (~50 мм/с), температуру стола до ~75 °C.
- **Обезжирьте** пластину изопропиловым спиртом (тереть с ворсом несколько раз, не просто мазнуть), либо **помойте** Fairy; для PETG часто лучше **без клея** или с тонким слоем адгезива.
- Проверьте **сушку** филамента; для капризных моделей — текстурированная PEI (подходит от Ender).
- Подробно про адгезию и коробление — [Печать](Печать.md#адгезия-прилипание-к-столу).

## Поддержки тяжело снимаются
- Тип: обычные — проще; древовидные — для сложной геометрии и PETG/ABS.
- **Z Distance** 0.1–0.2 мм, плотность 5–10 % (обычные) / 2–5 % (дерево), включите 1–2 слоя **интерфейса**, минимальная контактная площадь.
- См. также [Дефекты → поверхность над поддержками](Дефекты-печати.md).

## Смещение слоёв (layer shift)
- Чаще всего сопло **цепляет модель** (задравшийся край/наплыв) → снизьте скорость/ускорение, проверьте Z-offset.
- Если повторяется на разных моделях/пластиках — возможна плата; пишите в [поддержку](Обслуживание.md#гарантия-и-поддержка). См. [Дефекты → смещение слоёв](Дефекты-печати.md).

## Стрингинг / «паутина», «ворс»
Сушка филамента + калибровка ретракта — в [Печать → стрингинг](Печать.md#стрингинг-и-ворс).

## Принтер «звонит домой» / сам предлагает обновиться
Чтобы отключить автообновление, телеметрию и заливку фото/видео в китайские облака — заблокируйте на роутере домен обновлений **`update.sz3dp.com:10443`** (или примените правку из [Прошивки](Прошивка.md#обновление-и-откат)). Это же спасает разблокировку 320 °C от слёта.

## Принтер не загружается («кирпич»), не видит флешку
Восстановление через UART/U-Boot/FEL — [Электроника → восстановление «кирпича»](Электроника.md#восстановление-кирпича-не-грузится-не-видит-флешку).

## Ошибки E0017 / E0011
- **E0017 (Move Queue Overflow)** — улучшить охлаждение отсека + фикс `fix_e0017`.
- **E0011 (Communication Timeout)** — фикс `fix_e0011`, проверить шлейфы.
- Подробно — [Исправление ошибок](Исправление-ошибок.md).

## Не привязывается к FlashMaker / Orca-Flashforge
Обычно помогает **восстановление серийного номера** (`/opt/config/Adventurer5M.json`). См. [Исправление ошибок](Исправление-ошибок.md#ошибки-подключения-к-flashmaker--orca-flashforge).

## Стол кривой, не выровнять
Трёхэтапно: ремни → винты по углам → алюминиевый скотч; анализ карты — программой/онлайн. Полностью — [Калибровка → стол](Калибровка.md#калибровка-стола).

## Не отправляется большой файл по Wi-Fi
Практический потолок — около **25 МБ**. Печатайте с флешки либо облегчите G-code. См. [Слайсер](Слайсер-и-профили.md#файл-не-уходит-на-принтер-по-wi-fi).

## Не сохраняется статический IP
Принтер берёт случайный IP при включении — закрепляйте адрес **по MAC на роутере** (DHCP-резервация). См. [Сеть](Сеть-и-удалёнка.md).
