lDOCI/lDOCI.github.io/docs/Материалы.md

> [← Оглавление](index.md)

# Филаменты и материалы

Каталог конкретных катушек (тип, вес, размеры, ссылки на покупку) — в онлайн-таблице **[ldoci.github.io/filaments](https://ldoci.github.io/filaments/)** (с фильтром и поиском). Здесь — практика по типам пластика, сушке и мультицветной печати. Параметры печати и дефекты — в [Печать](Печать.md).

> **Примечание:**
> Сопло AD5M из нержавейки греет хуже латуни — добавляйте **~+15 °C** к «справочным» температурам с катушки.

## Где брать филамент

- **Локальные (Ozon/WB/магазины):** 3D-Club, FDPlast, Bestfilament, Filamentarno, Novaprint, Syntech, НИТ, u3print, absmaker, KREMEN и др.
- **AliExpress/Ozon:** Sunlu, Anycubic, Geeetech, eSUN, Eryone, FlashForge.

Чем дороже производитель — тем обычно лучше выходной контроль, но косяки бывают у всех. Дешёвый пластик чаще требует калибровки потока/PA под каждую катушку.

## Сушка

Почти любой филамент набирает влагу и начинает давать дефекты (пузыри, «ворс», хрупкость). Сушить особенно важно полипропилен и нейлон, но PETG и ABS тоже гигроскопичны.

- Лучше всего — специализированные сушилки: **Sunlu FilaDryer S2 / S4**, **Eibos Cyclops / Polyphemus**, **Creality Space Pi**, либо DIY-проект **iDryer**. Бюджетно и эффективно — обычная **сушилка для фруктов/овощей**.
- **Духовка — на свой риск:** многие завышают температуру на 10–20 °C, чего хватает, чтобы повело пруток или саму катушку.
- Для нейлонов/композитов: 80–90 °C, 6–8 ч (следите, чтобы катушка выдержала температуру), печать сразу из сушилки или из гермобокса с силикагелем.

## По типам пластика

**PLA** — самый простой; обычная температура, обдув 100%.

**PETG** — рабочая лошадка (≈60–70% бытовых задач). Реально ~255–265 °C (на 270 «кипит»), объём ~12–20 мм³/с. Стоек к химии, держит от −25 до ~60–70 °C. Склонен к отрывам/короблению на крупных моделях — снижают обдув, ставят зашивку (см. [Печать](Печать.md)).

**ABS/ASA** — нужна закрытая камера (термокамера), иначе коробит и расслаивает; характерный запах — проветривание/фильтр.

**TPU (флекс):**
- Жёсткость: **85A** — универсальный средний вариант; мягче (например 75A) принтер может не протянуть, печать очень медленная (2–4 мм/с, для 85A ~25 мм/с).
- Подача — **прямой короткий путь** в голову (держатель катушки сверху, без тефлоновой трубки и петель). Для прутка тоньше 1.6 мм — [убрать ограничители в фидере](Прошивка.md).
- В слайсере **отключить ретракт и Z-hop**, сопло **0.4** (тоньше — пробки), стол 50–60 °C, клей (адгезия бывает чрезмерной), 1–2 периметра, заполнение ~15 %, поддержки со 100 % заполнением. Температуру подобрать по башне.

**Композиты (PA-GF, PP-GF, ABS-GF, *CF)** — самое сложное:
- Сильное коробление без **активной камеры**; прогревайте камеру максимально (42–43 °C в закрытом помещении реально, лучше больше).
- Помогает уменьшить число периметров и сплошных слоёв сверху/снизу (правило против коробления для любых пластиков).
- Адгезия: готовый клей для стекла по инструкции либо [PVP K90](Печать.md).
- **PACF** (например eSUN) — самый простой из PA. **PAGF30/PPGF30** дешевле, но сложнее. **HT** наш принтер не осилит.
- Обязательная тщательная сушка (см. выше).

## Мультицветная / мультиматериальная печать (ручная смена)

Без IFS цвет меняют вручную через паузу:

1. В слайсере добавьте второй пруток, раскрасьте модель нужным инструментом (диапазон слоёв / отсечение вида).
2. В настройках принтера → G-code при смене прутка впишите `PAUSE`.
3. Включите **черновую башню** (рекомендуется): в «Экструдер ММ» все параметры = `0` (прогон делаем вручную), выключите «рэмминг прутка», включите «ручная замена прутка», объём очистки множитель `0.01–0.1`.
4. Печать. На паузе: сдвинуть тефлоновую трубку, отрезать филамент, смотать, загрузить новый в трубку, с экрана зайти в меню смены прутка, прогнать новый (он прогонит с запасом), возобновить печать.

> **Важно:**
> Отключите «исключение объектов» — после возобновления печати оно может повесить принтер. В названиях моделей на столе **не используйте кириллицу**.
