lDOCI/lDOCI.github.io/files/1766615750330_Инструкция_по_доработке_блока_питания_FFAD5M5MPRO.docx

Инструкция по доработке блока питания FFAD5M(5MPRO)

1. Для начала нужно приобрести термореле (термостат). Я приобрел такой

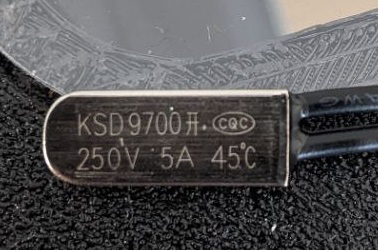
[picture p57: figure]

2. Необходимо демонтировать блок питания из принтера. Для этого снимаем заднюю крышку выкрутив 6 винтов. Затем выкручиваем 4 винта крепящих блок питания к корпусу принтера ,доступ к ним внутри рабочего объёма 4 шахты на задней стенке Откручиваем 7 винтов клемм проводов блока питания и он у нас в руках.

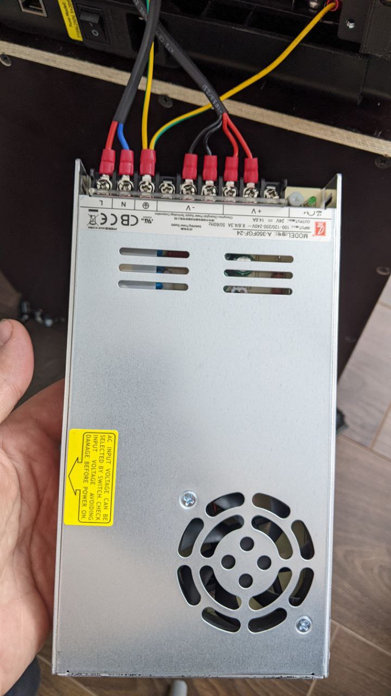
[picture p58: figure]

3. Разбираем блок питания выкрутив 4 Виета на корпусе по краям (Один из них под наклейкой).

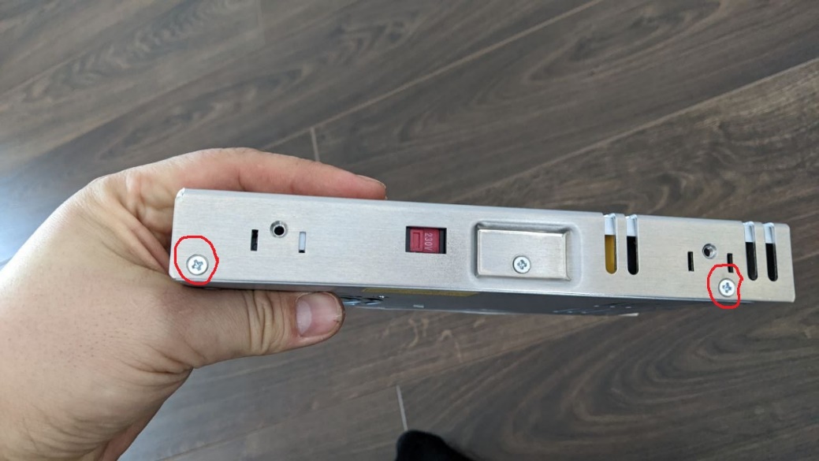
[picture p59: figure]
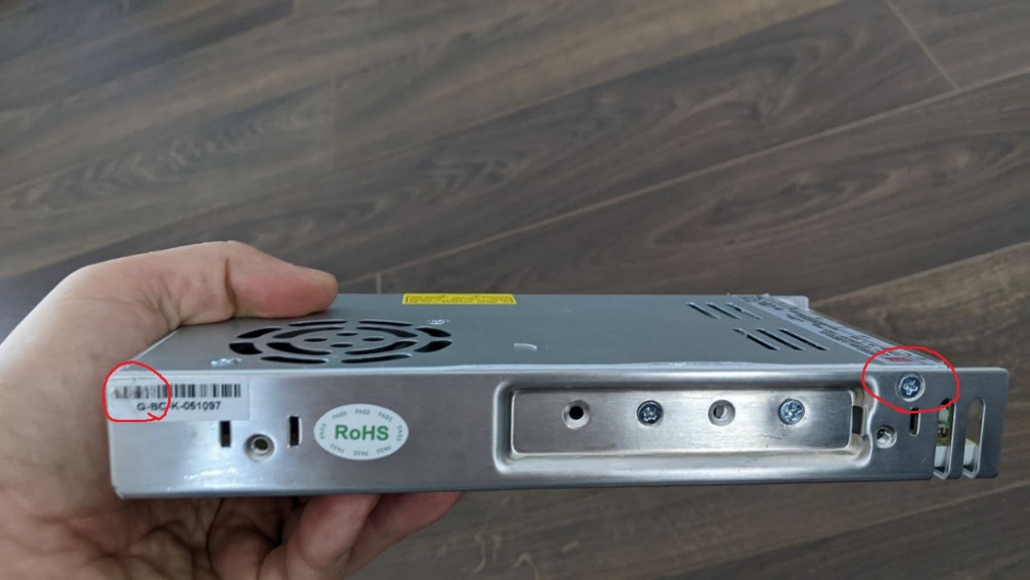
[picture p60: figure]

И отделяем крышку, отключив разъём вентилятора блока питания.

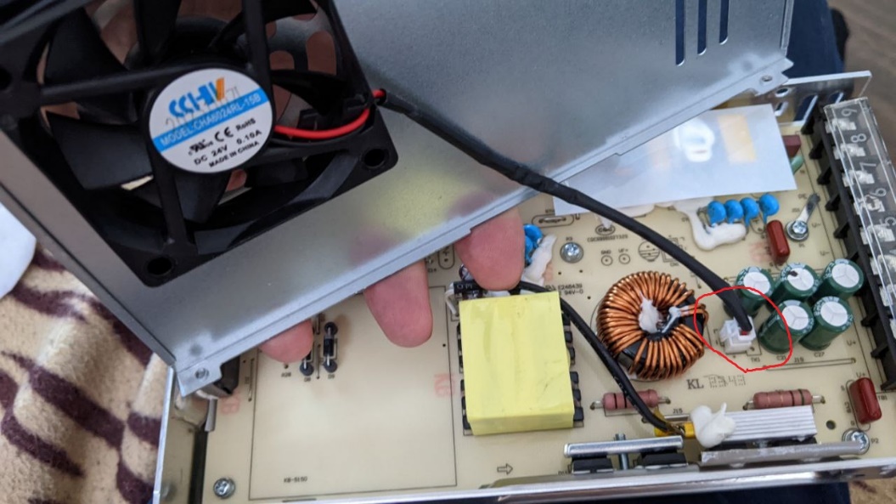
[picture p61: figure]

4. Откручиваем все винты крепления элементов к корпусу блока питания и винты крепления платы и извлекаем её. Будьте осторожны, китайцы напихали очень много термопасты и я, например, весь в ней перепачкался.

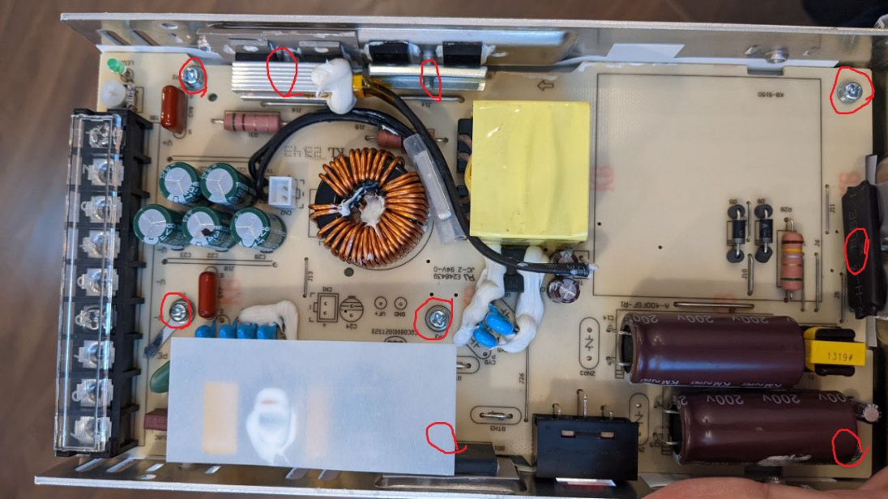
[picture p62: figure]

5. Берем паяльник и выпаиваем перемычку J29, затем впаиваем провода термореле в штатное место.

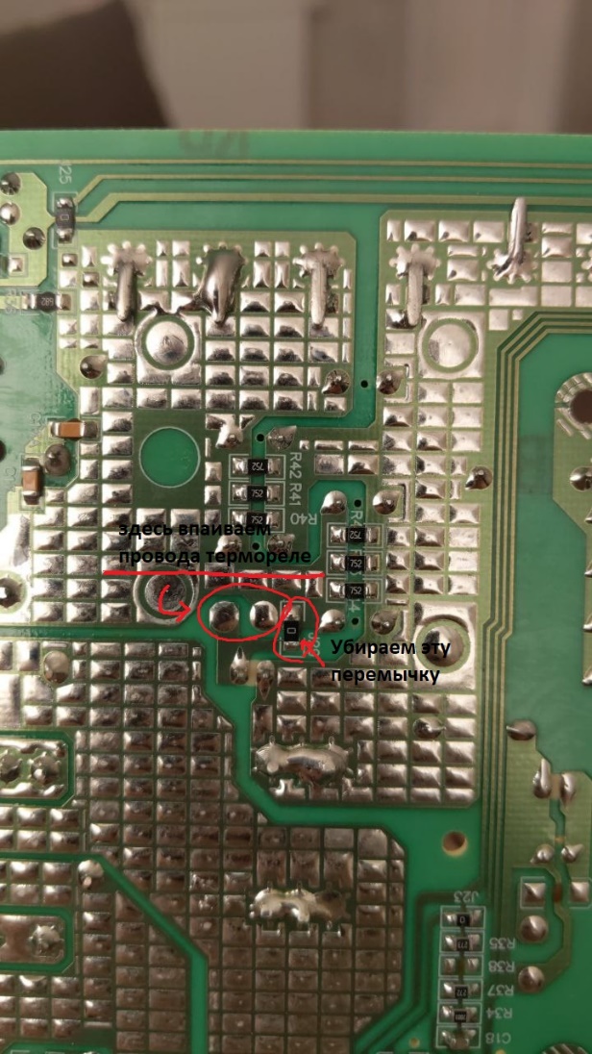
[picture p63: figure]

Должно получиться вот так

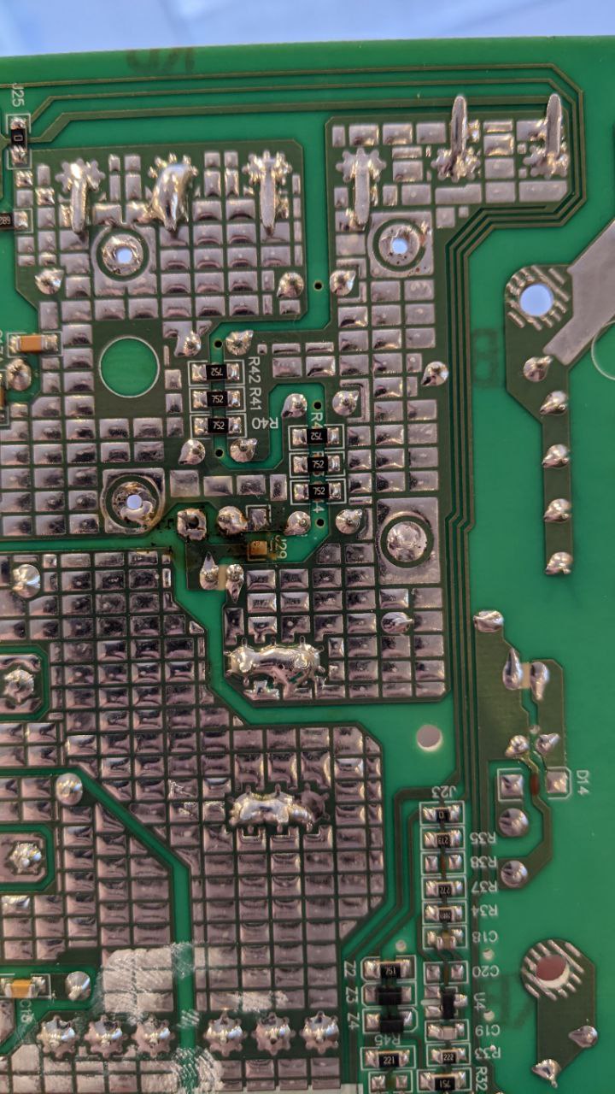
[picture p64: figure]

6. Устанавливаем плату на место и собираем все в обратной последовательности 😉

Сам термостат я расположил вот так и ничем не крепил, его хорошо зажимают провода.

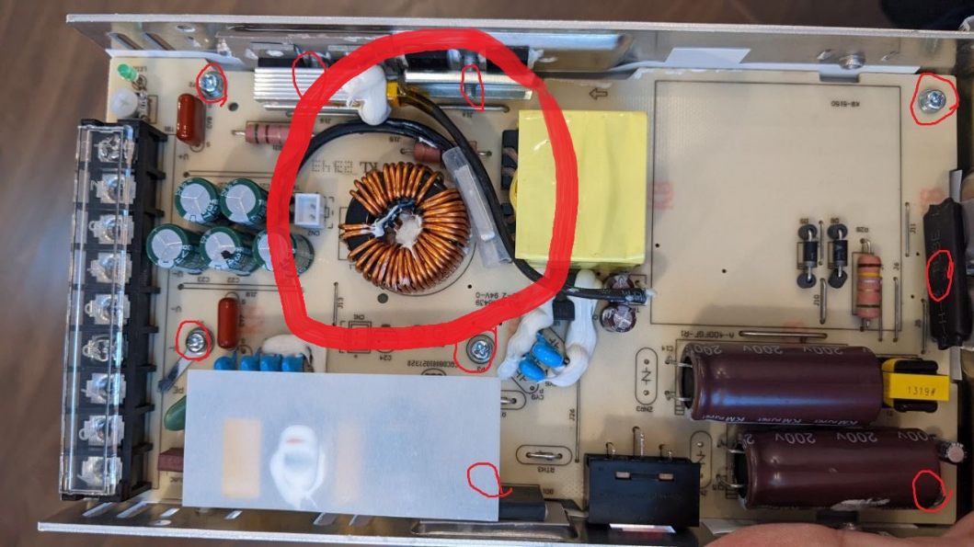
[picture p65: figure]
