lDOCI/lDOCI.github.io/images/1766613022158_image.png

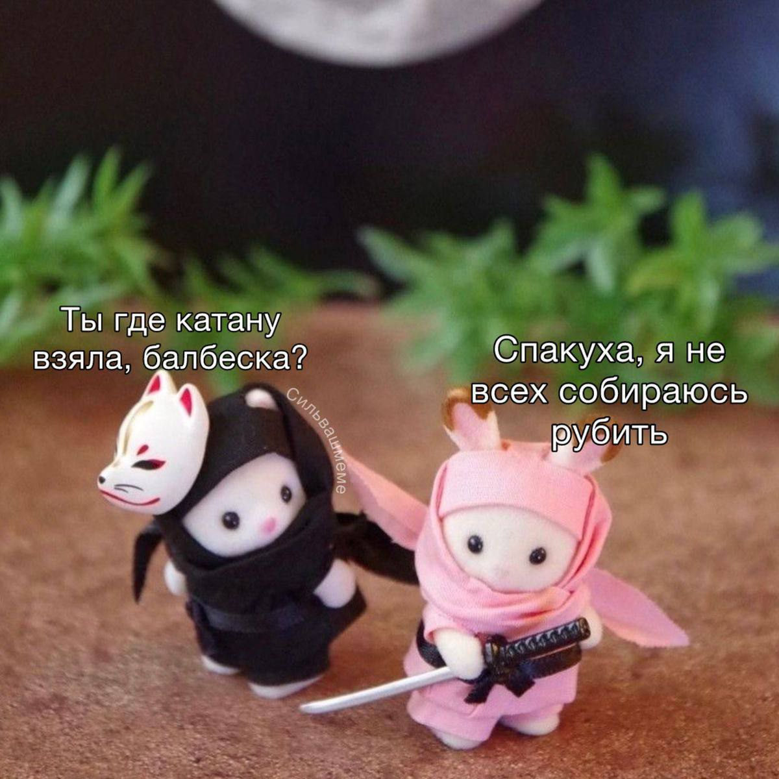
images/1766613022158_image.png
