lDOCI/lDOCI.github.io/images/1766613324560_{235719B0-E614-49A7-A09E-F6362447FE2D}.png

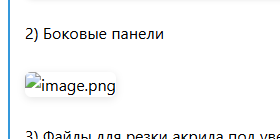
images/1766613324560_{235719B0-E614-49A7-A09E-F6362447FE2D}.png
