lDOCI/lDOCI.github.io/images/1766614045339_image.png

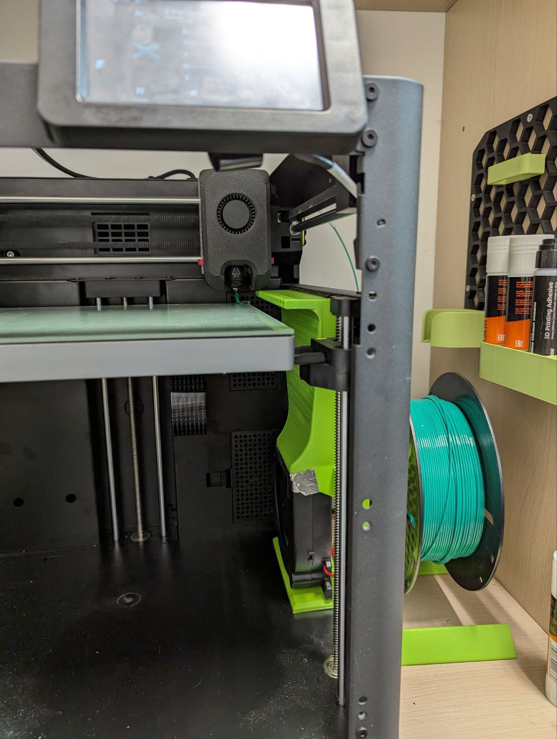
images/1766614045339_image.png
