lDOCI/lDOCI.github.io/images/1766614051244_image.png

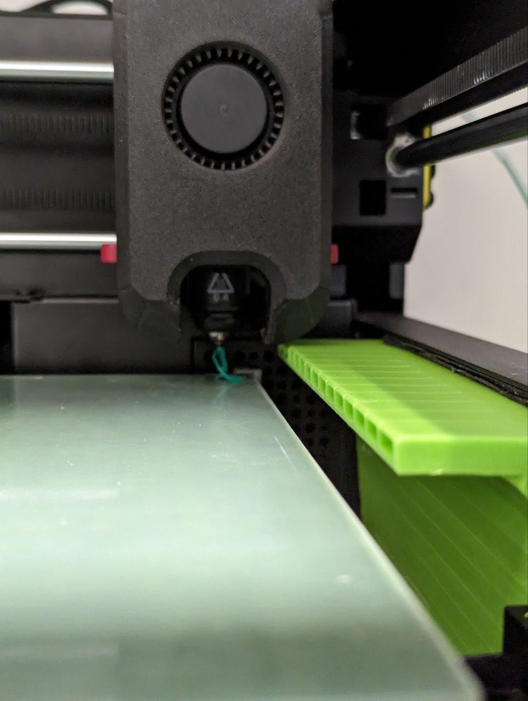
images/1766614051244_image.png
