lDOCI/lDOCI.github.io/images/1766614821195_image.png

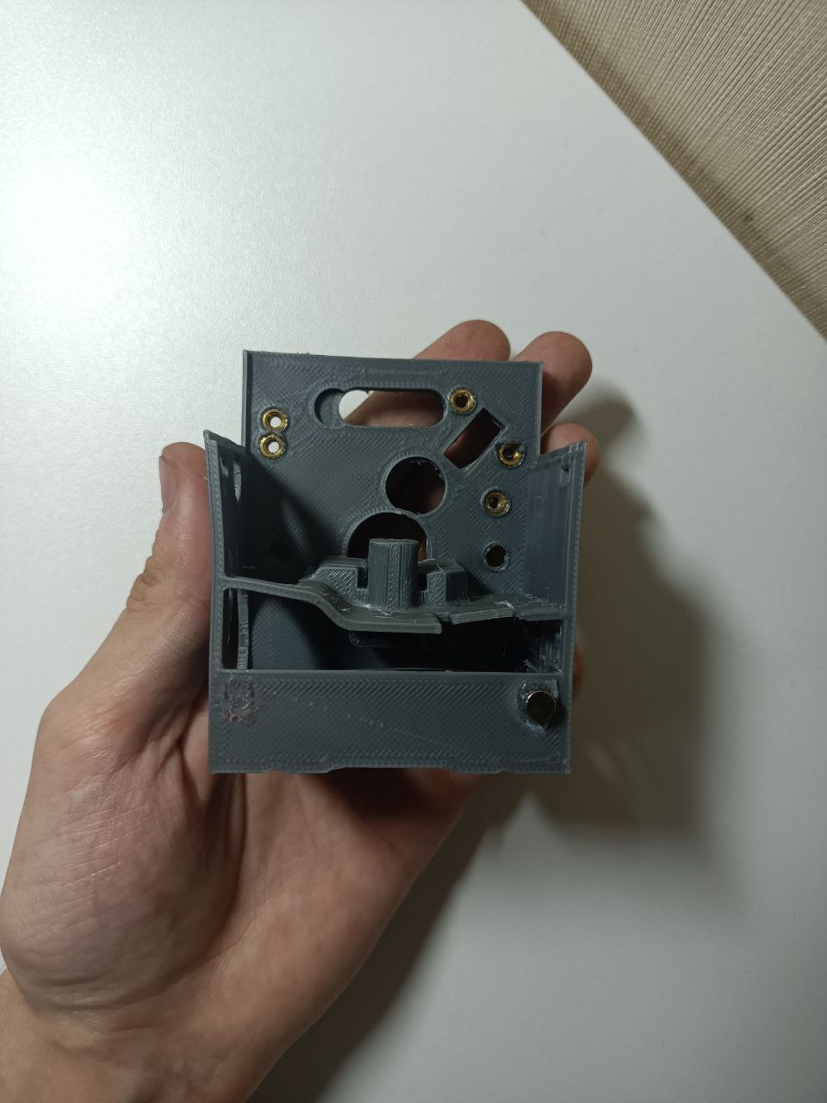
images/1766614821195_image.png
