lDOCI/lDOCI.github.io/images/1766614847260_image.png

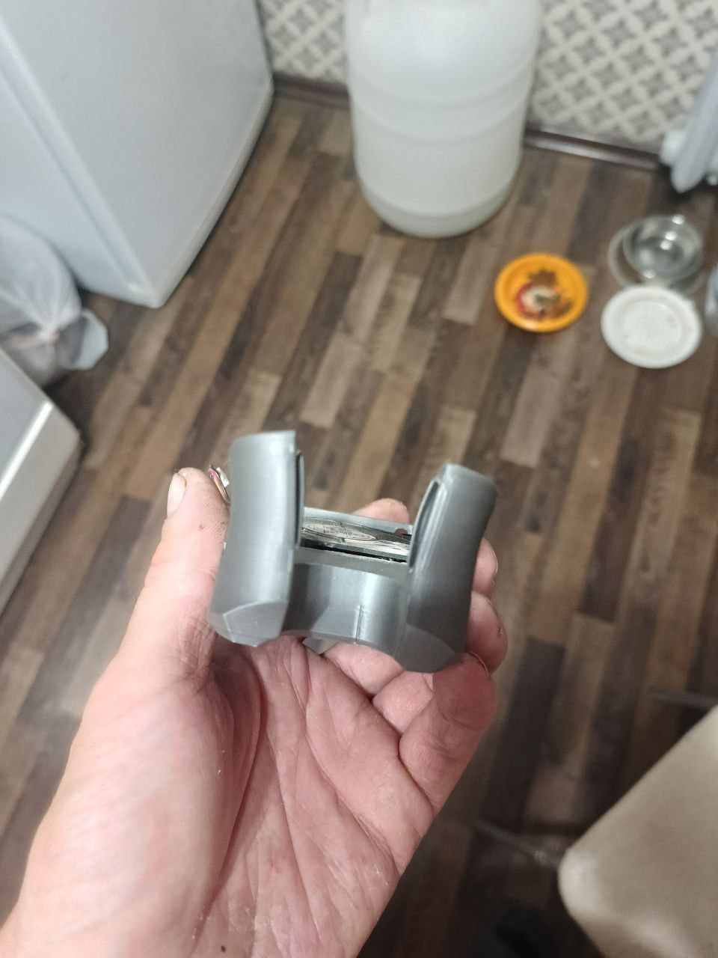
images/1766614847260_image.png
