lDOCI/lDOCI.github.io/images/1766614851220_image.png

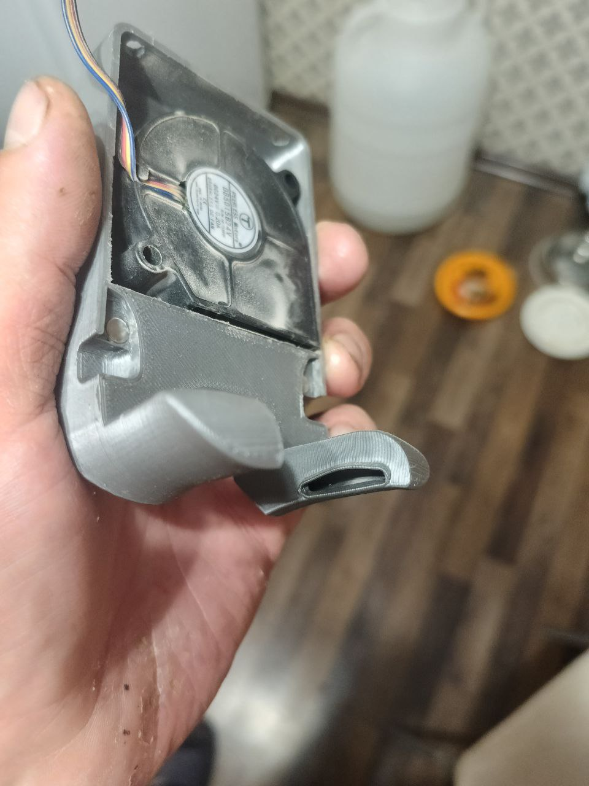
images/1766614851220_image.png
