lDOCI/lDOCI.github.io/images/1766614854421_image.png

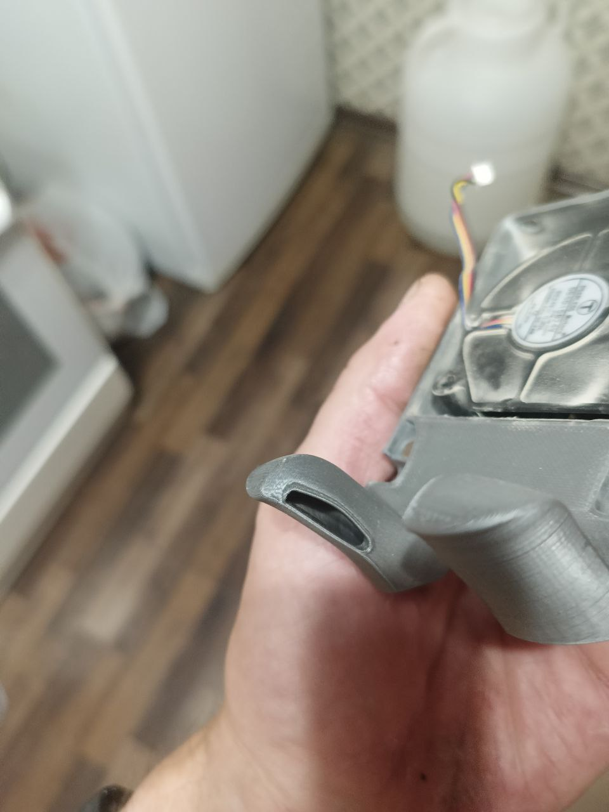
images/1766614854421_image.png
