lDOCI/lDOCI.github.io/images/1766615039562_image.png

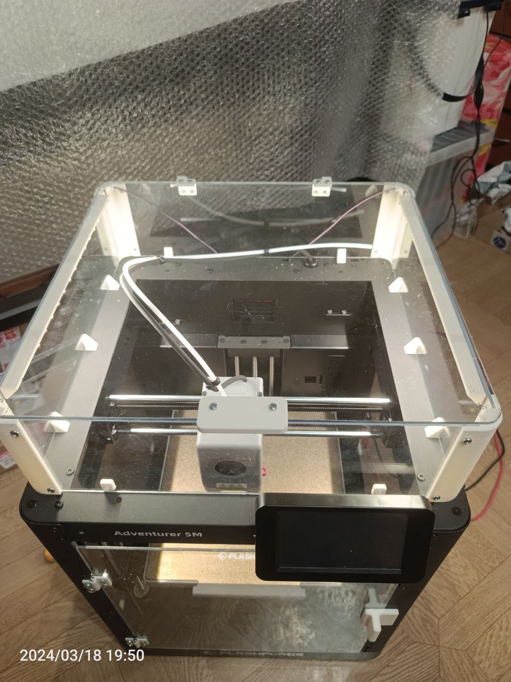
images/1766615039562_image.png
