lDOCI/lDOCI.github.io/images/1766615043502_image.png

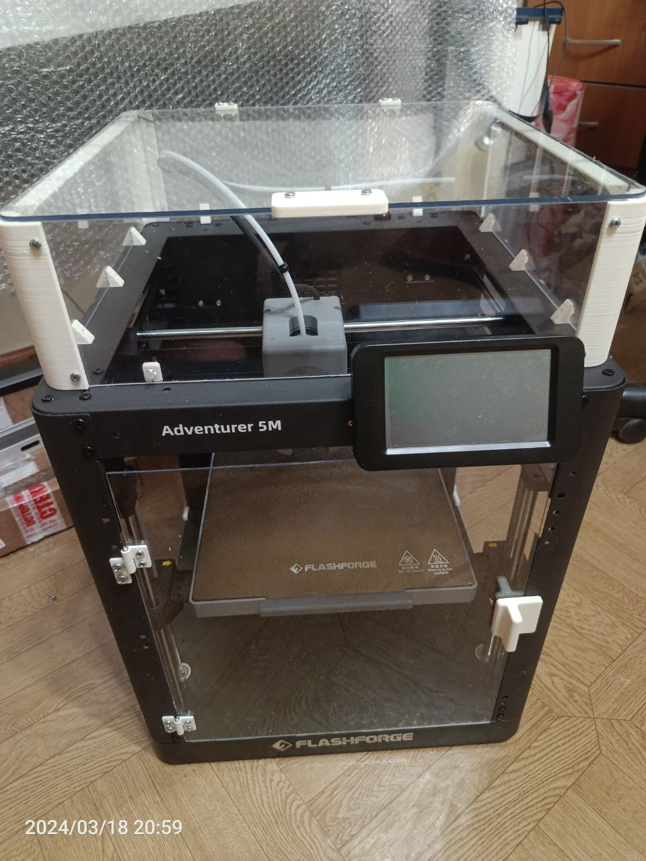
images/1766615043502_image.png
