lDOCI/lDOCI.github.io/images/1766615325351_image.png

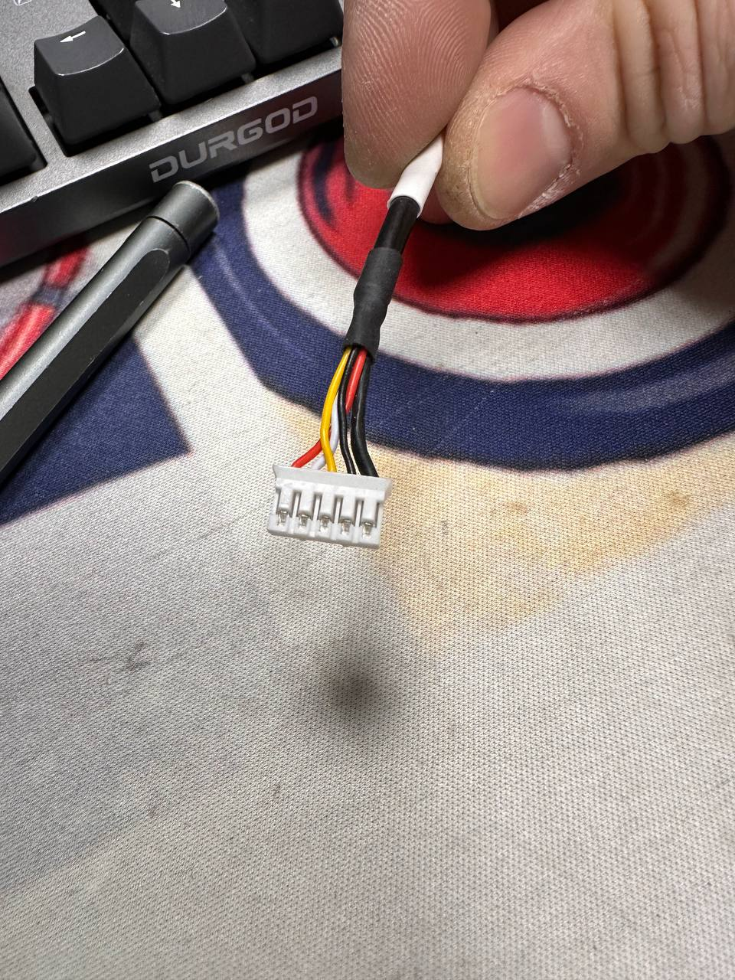
images/1766615325351_image.png
