lDOCI/lDOCI.github.io/images/1766615356594_image.png

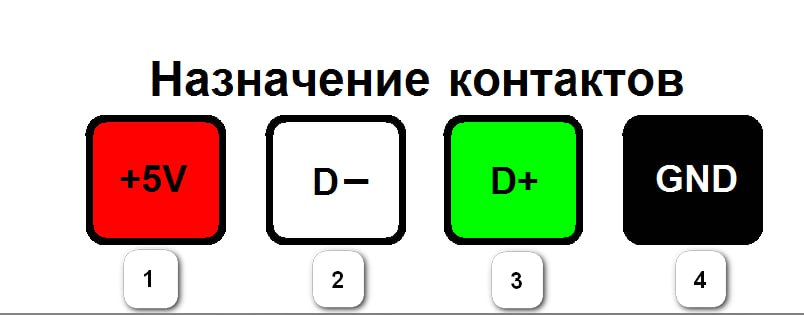
images/1766615356594_image.png
