lDOCI/lDOCI.github.io/images/1766615483917_image.png

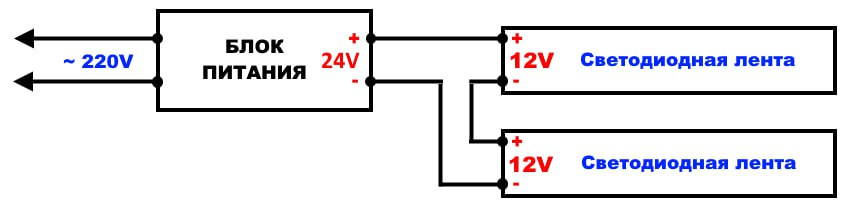
images/1766615483917_image.png
