lDOCI/lDOCI.github.io/images/1766615552123_image.png

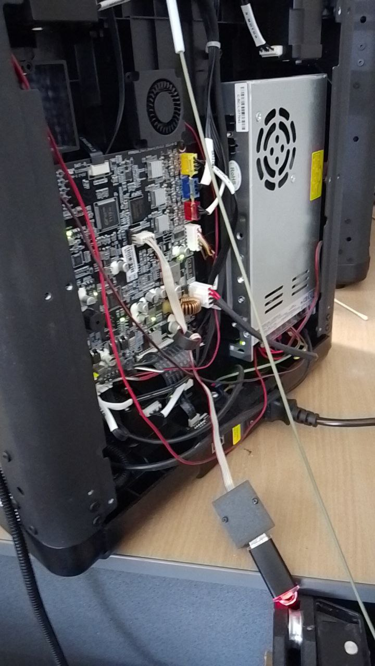
images/1766615552123_image.png
