lDOCI/lDOCI.github.io/images/1766615555931_image.png

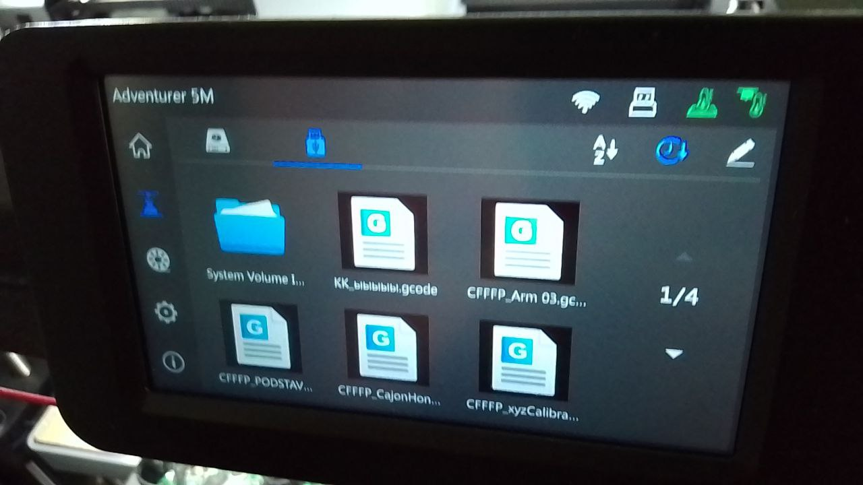
images/1766615555931_image.png
