lDOCI/lDOCI.github.io/images/1766615604399_image.png

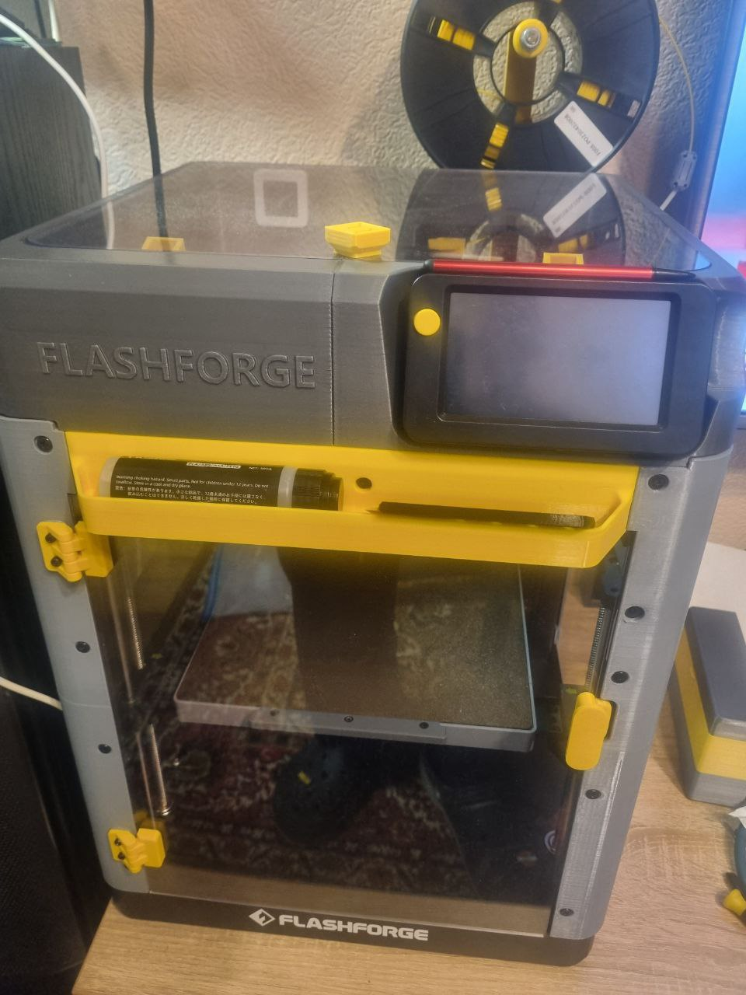
images/1766615604399_image.png
