lDOCI/lDOCI.github.io/images/1766615607838_image.png

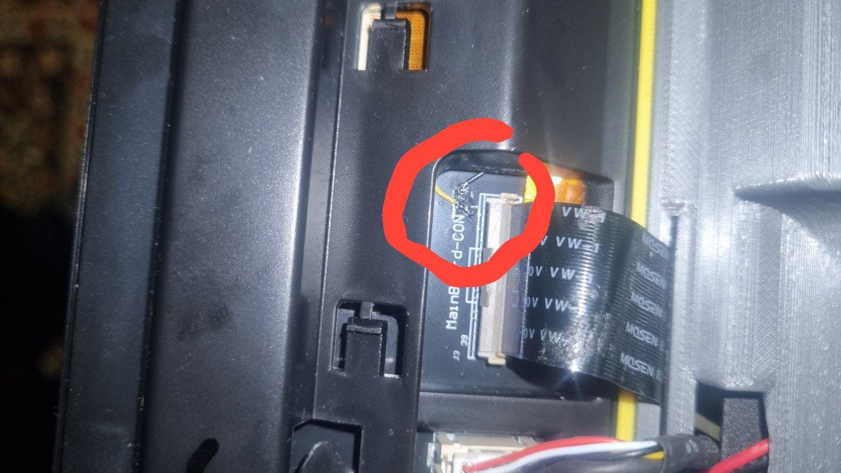
images/1766615607838_image.png
