lDOCI/lDOCI.github.io/images/1766615690397_image.png

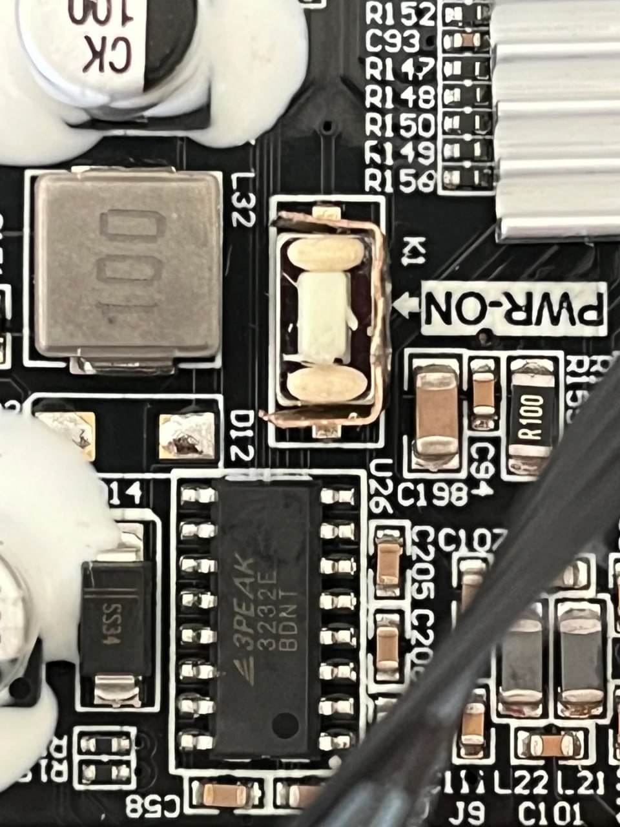
images/1766615690397_image.png
