lDOCI/lDOCI.github.io/files/1766614214951_D4.step

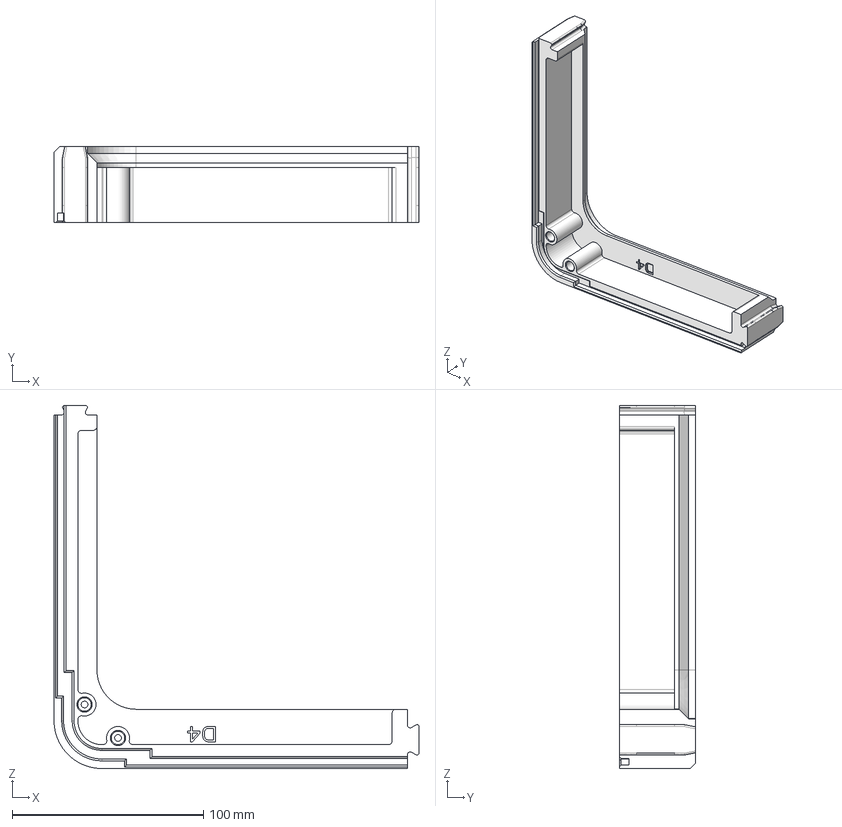
[picture p84: CAD file, 2025-12-24]
files/1766614214951_D4.step
191.0 x 40.0 x 190.0 mm
