lDOCI/lDOCI.github.io/files/1766614212933_Kreplenie.step

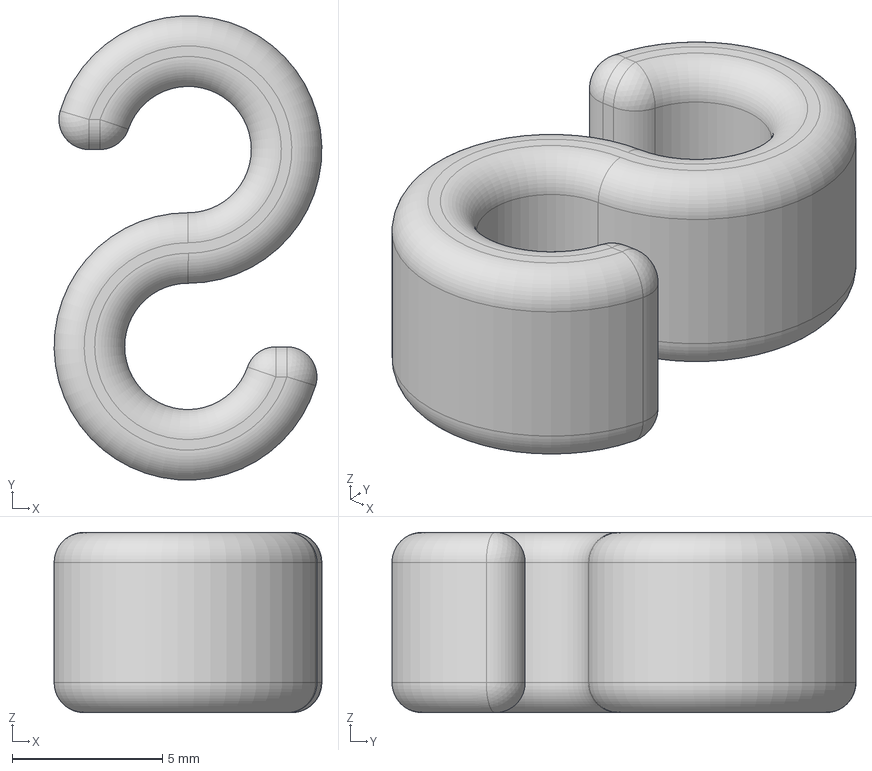
[picture p85: CAD file, 2025-12-24]
files/1766614212933_Kreplenie.step
8.91 x 15.4 x 6.00 mm
