lDOCI/lDOCI.github.io/files/1766614210612_A3.STEP

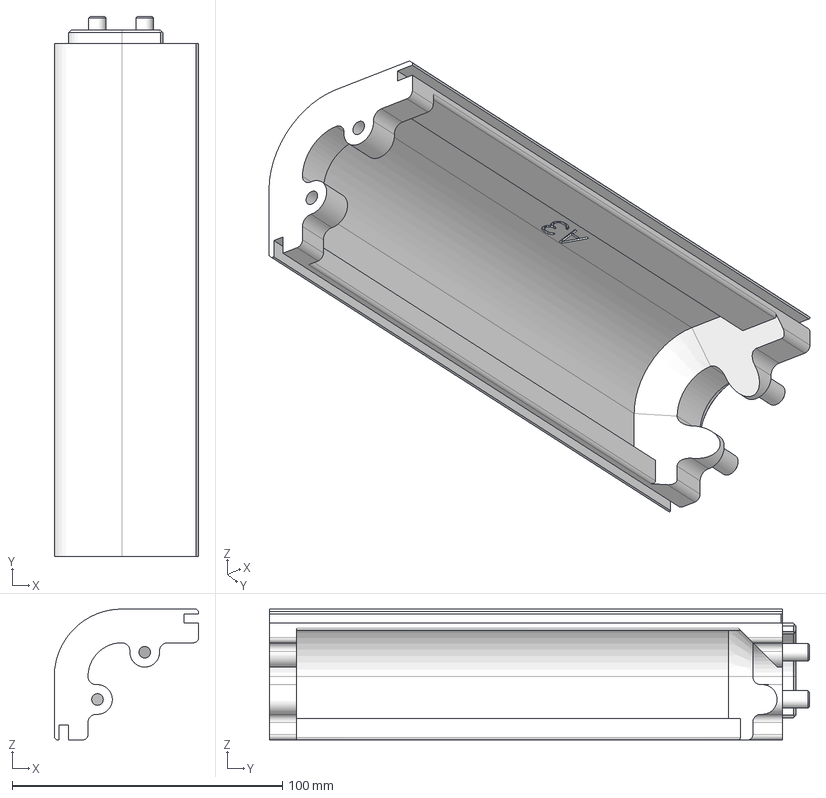
[picture p86: CAD file, 2025-12-24]
files/1766614210612_A3.STEP
53.5 x 200.0 x 48.5 mm
