lDOCI/lDOCI.github.io/files/1766614208305_B3.STEP

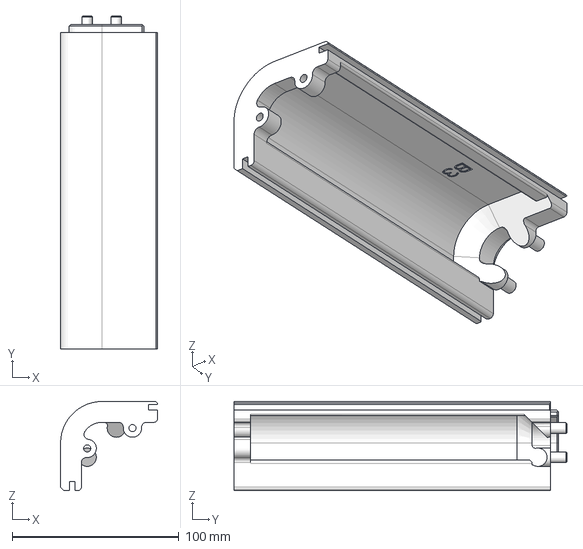
[picture p87: CAD file, 2025-12-24]
files/1766614208305_B3.STEP
58.2 x 200.0 x 53.5 mm
