lDOCI/lDOCI.github.io/files/1766614201301_A4.step

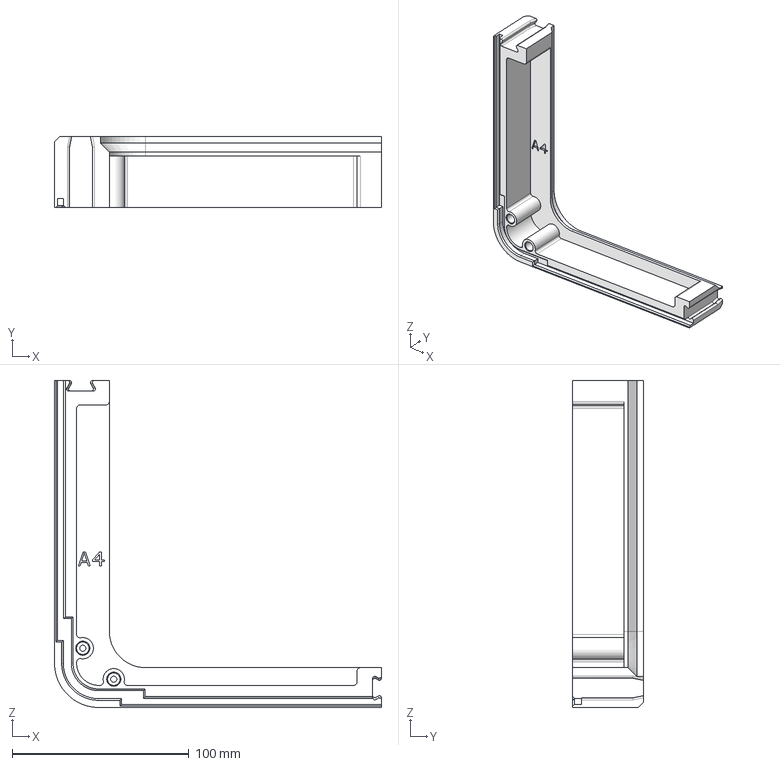
[picture p88: CAD file, 2025-12-24]
files/1766614201301_A4.step
184.8 x 40.0 x 184.8 mm
