lDOCI/lDOCI.github.io/files/1766614199114_B4.step

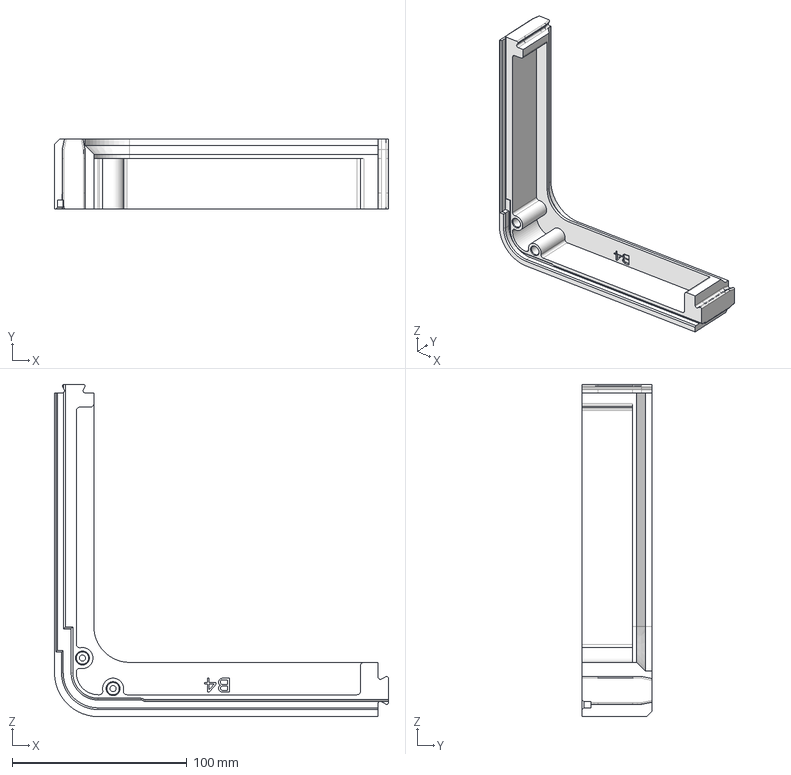
[picture p89: CAD file, 2025-12-24]
files/1766614199114_B4.step
191.0 x 40.0 x 190.0 mm
