lDOCI/lDOCI.github.io/files/1766614065918_ff-side-blower-top.3mf

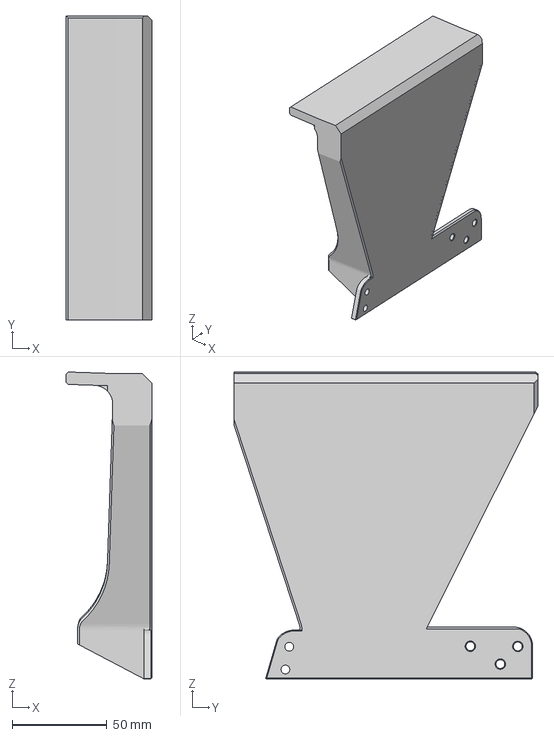
[picture p90: CAD file, 2025-12-24]
files/1766614065918_ff-side-blower-top.3mf
45.1 x 160.0 x 161.7 mm
