lDOCI/lDOCI.github.io/files/1766614063012_ff-side-blower-bottom.3mf

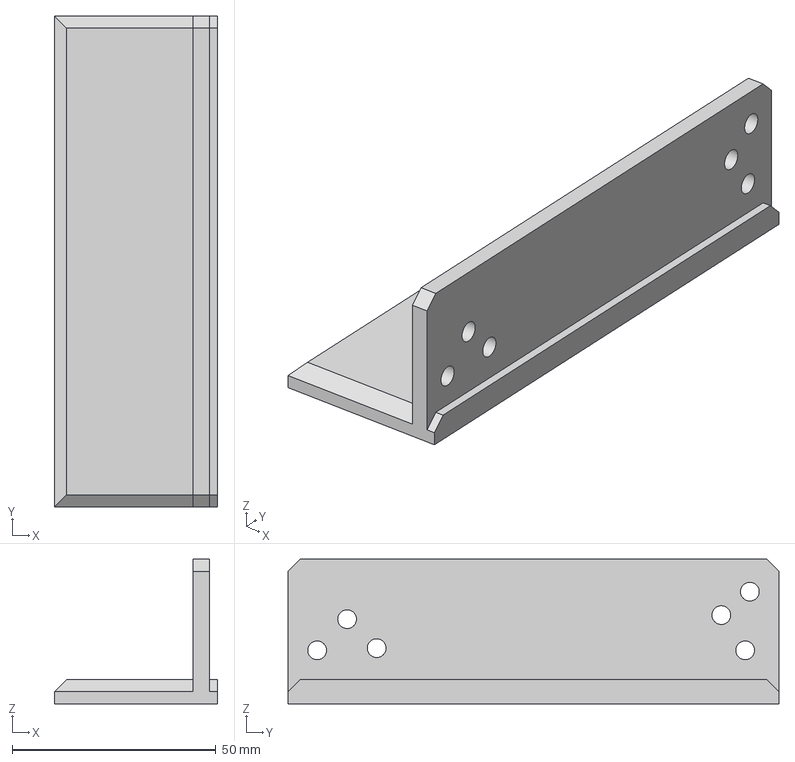
[picture p91: CAD file, 2025-12-24]
files/1766614063012_ff-side-blower-bottom.3mf
40.0 x 120.5 x 35.6 mm
