lDOCI/lDOCI.github.io/files/1766611675973_стеночки для ff ad5.dxf

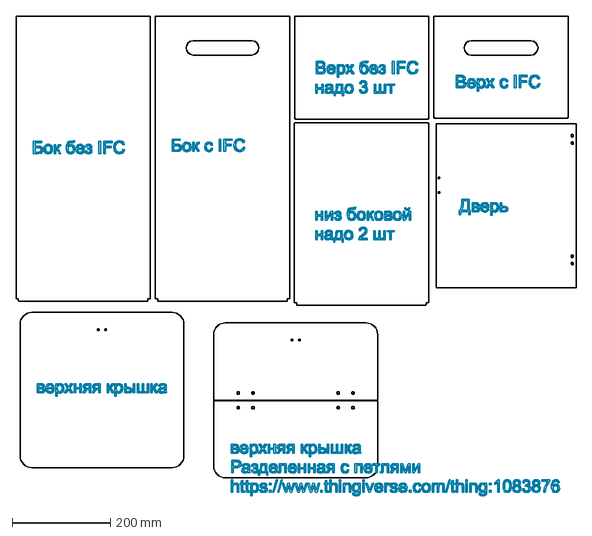
[picture p92: CAD file, 2025-12-24]
files/1766611675973_стеночки для ff ad5.dxf
1137.7 x 974.6 mm
