lDOCI/lDOCI.github.io/(list of files, cad)

Other CAD files:
files/1766614205926_C3.STEP
files/1766614203659_D3_.step
files/1766614196815_C4.step
old/files/1766614205926_C3.STEP
old/files/1766614203659_D3_.step
old/files/1766614196815_C4.step
