lDOCI/lDOCI.github.io/(commit log)

2025-12-24 New post: Кастомные зашивки корпуса:
2026-05-25 Новая вики FlashForge AD5M/5X (MkDocs Material), старый сайт в old/
    [1766611675973_стеночки для ff ad5.dxf, 1766614063012_ff-side-blower-bottom.3mf, 1766614065918_ff-side-blower-top.3mf, 1766614196815_C4.step, 1766614199114_B4.step, 1766614201301_A4.step, 1766614203659_D3_.step, 1766614205926_C3.STEP]
2026-05-26 Прошивка: уточнение ZMod/Forge-X
2026-07-25 Правки вики по разбору чат-дампа
    Сверка 20 статей с телеграм-дампом (#500053–#1461612):
    Исправлены фактические ошибки: шкивы 20T W6 B5 without T (гладкие,
    12 шт), две битые ссылки Printables заменены живыми.
    Новые разделы:
    - Исправление-ошибок: камера как причина зависаний (маскируется
    под битые файлы), кириллица в именах — спор с обеими сторонами
    - Электроника: замеры вентилятора 3010, датчики Холла в голо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
2026-07-25 index: убрать методологическую приписку про дамп
